mfkiwl/STM32H743_HW/README.md

# IT_Asset_Tracking_Rack_Controller-H743_HW
HW files for the Asset Tracking Rack Controller. It's  based on a STM32H743BIT6 4 layer board which is powered by PoE.
