mfkiwl/STM32H743_HW/Project Outputs for IT_Asset_Tracking_Rack_Controller-H743/Bill of Materials-IT_Asset_Tracking_Rack_Controller-H743.xls

Designator | value | Description | Manufacturer PartNr | Footprint/Package | Replaceable | Quantity
C10, C25, C31, C32, C36 | 4.7uF | 4.7µF ±10% 10V Ceramic Capacitor X5R 0603 (1608 Metric), 4.7µF ±10% 16V Ceramic Capacitor X5R 0603 (1608 Metric), 4.7µF ±10% 35V Ceramic Capacitor X5R 0603 (1608 Metric) | C0603C475K8PACTU | 0603 (1608 metric) | yes | 5
C35 | 4.70uF | 4.7µF Molded Tantalum Capacitors 6.3V 0603 (1608 Metric) 7.5Ohm | TACL475K006XTA | 0603 (1608 Metric) | yes | 1
R2 | 0R | 0 Ohms Jumper 0.1W, 1/10W Chip Resistor 0603 (1608 Metric) Moisture Resistant Thick Film | RC0603JR-070RL | 0603 (1608 metric) | yes | 1
R46, R85, R86 | 0R | 0 Ohms Jumper 0.125W, 1/8W Chip Resistor 0805 (2012 Metric) Automotive AEC-Q200 Thick Film | ERJ-6GEY0R00V | 0805 (2012 metric) | yes | 3
R100, R107 | 0R | 0 Ohms Resistor 0402 | ERJ-2GE0R00X | 0402 (1005 metric) | yes | 2
C1, C2, C3, C4, C5, C6, C7, C8, C12, C14, C15, C16, C17, C18, C19, C20, C22, C23, C40, C46, C49, C50, C51, C52, C54, C78, C83, C103, C104 | 100nF | 0,1µF ±10% 10V Keramikkondensatoren X7R 0402 (1005 metrisch), 0.1µF ±10% 6.3V Ceramic Capacitor X7R 0402 (1005 Metric) | CC0402KRX7R6BB104 | 0402 (1005 metric) | yes | 29
C21, C27, C28, C33, C34, C37, C38, C39, C56, C63, C70, C72, C87, C91, C92, C98, C100, C101, C102 | 0.1uF | 0.1µF ±20% 10V Ceramic Capacitor X5R 0402 (1005 Metric), 0.1µF ±20% 16V Ceramic Capacitor X7R 0402 (1005 Metric), 0.1µF ±10% 16V Ceramic Capacitor X7R 0402 (1005 Metric) | 885012105010 | 0402, 0402 (1005 Metric) | yes | 19
C89 | 0.5pF | 0.5pF ±0.05pF 50V Ceramic Capacitor C0G, NP0 0402 (1005 Metric), Murata | GJM1555C1HR50WB01D | 0402 (1005 metric) | yes | 1
C88 | 0.8pF | 0.8pF ±0.1pF 50V Ceramic Capacitor C0G, NP0 0402 (1005 Metric) | GJM1555C1HR80BB01D | 0402 (1005 metric) | yes | 1
R31 | 1K5 | 1 kOhms ±0.5% 0.063W, 1/16W Chip Resistor 0402 (1005 Metric) Thin Film | CRGCQ0402F1K5 | 0402 (1005 metric) | yes | 1
R87 | 1K | 1 kOhms ±0.5% 0.063W, 1/16W Chip Resistor 0402 (1005 Metric) Thin Film | RR0510P-102-D | 0402 (1005 metric) | yes | 1
R6, R58 | 1M | 1 MOhms ±1% 0.1W, 1/10W Chip Resistor 0402 (1005 Metric) Anti-Sulfur Thin Film | MCS04020C1004FE000 | 0402 (1005 metric) | yes | 2
C24, C26, C81, C82, C99 | 1uF | 1µF ±10% 10V Ceramic Capacitor X7S 0402 (1005 Metric), 1µF ±10% 16V Ceramic Capacitor X5R 0603 (1608 Metric) | GCM155C71A105KE38D | 0402 (1005 metric), 0603 (1608 Metric) | yes | 5
C11, C13, C41 | 1uF | 1µF ±10% 25V Ceramic Capacitor X5R 0603 (1608 Metric) | C0603C105K3PACTU | 0603 (1608 metrisch) | yes | 3
R60, R61, R62 | 1.2K | 1.2 kOhms ±0.5% 0.063W, 1/16W Chip Resistor 0402 (1005 Metric) Thin Film | ERA-2AED122X | 0402 (1005 metric) | yes | 3
P1 | M50-3530242 | 2 Pin, 1 Row, Jumper, 1.27mm | M50-3530242 | 1.27mm | yes | 1
E1 | ANT 2.4GHZ | 2,4GHz Bluetooth, Wi-Fi, Zigbee PCB HF-Antenna,1dBi SMD, Antenova | A5839 | specific see datasheet | no | 1
C42, C43, C47 | 2.2uF | 2.2µF ±20% 25V Ceramic Capacitor X5R 0402 (1005 Metric), Multilayer Ceramic Capacitors MLCC - SMD/SMT 0402 2.2uF 6.3volts *Derate Voltage/Temp | GRM155R61E225ME15D | 0402 (1005metric) | yes | 3
R8 | 3K3 | 3.3 kOhms ±0.1% 0.063W, 1/16W Chip Resistor 0402 (1005 Metric) Automotive AEC-Q200 Thin Film | ERA-2AEB332X | 0402 (1005metric) | yes | 1
L6 | 3.3nH | 3.3nH Unshielded Multilayer Inductor 800mA 170mOhm Max 0402 (1005 Metric) | LQG15HS3N3S02D | 0402 (1005 metric) | no | 1
R18 | 4.7K | 4.7 kOhms ±5% 0.063W, 1/16W Chip Resistor 0402 (1005 Metric) Moisture Resistant Thick Film | RC0402JR-074K7L | 0402 (1005) | yes | 1
C9, C53, C76, C77, C79 | 4.7uF | 4.7µF ±10% 10V Ceramic Capacitor X5R 0402 (1005 Metric), 4.7µF ±10% 6.3V Ceramic Capacitor X7R 0603 (1608 Metric) | CL05A475KP5NRNC | 0402 (1005 metric), 0603 (1608 metric) | yes | 5
C30 | 4.7uF | 4.7µF ±20% 6.3V Ceramic Capacitor X5R 0402 (1005 Metric) | GRM155R60J475ME47D | 0402 (1005 metric) | yes | 1
P5, P8 |  | 6Pin, 2Rows, MICRO LOW-PROFILE TERMINAL STRIPS | FTS-103-02-F-DV | see datasheet |  | 2
R80 | 7K15 | 7.15 kOhms ±0.1% 0.063W, 1/16W Chip Resistor 0402 (1005 Metric) Anti-Sulfur, Automotive AEC-Q200 Thin Film | RQ73C1E7K15BTD | 0402 (1005 metric) | yes | 1
R21 | 8.06K | 8.06 kOhms ±1% 0.063W, 1/16W Chip Resistor 0402 (1005 Metric) Moisture Resistant Thick Film | 311-8.06KLRCT-ND | 0402 (1005) | yes | 1
L4 | 8.2µH | 8.2µH Semi-Shielded Wirewound Inductor 3.7A 45mOhm Max Nonstandard | SRN8040-8R2Y | Specific see datasheet | no | 1
U9 | LAN8742A-CZ-TR | 10/100M RMII Ethernet transceiver 24-SQFN (4x4) | LAN8742A-CZ-TR | 24-VFQFN Exposed Pad | no | 1
C71 | 10uF | 10µF ±20% 10V Ceramic Capacitor X5R 0402 (1005 Metric) | CL05A106MP8NUB8 | 0402 (1005 metric) | yes | 1
C48 | 10uF | 10µF Molded Tantalum Capacitors 10V 1206 (3216 Metric) 3.4Ohm | 293D106X9010A2TE3 | 1206 (3216 metric) | yes | 1
C66, C67 | 10uF | 10µF Molded Tantalum Capacitors 10V 1206 (3216 Metric) 3.4Ohm | 293D106X9010A2TE3 | 1206 (3216 metric) | yes | 2
L1 | 10µH, 200mΩ | 10µH Shielded Wirewound Inductor 1.7A 200mOhm Max Nonstandard | FDSD0420-H-100M=P3 | Specific see datasheet | no | 1
L5 | 10uH | 10µH Unshielded Wirewound Inductor 80mA 360mOhm 0603 (1608 Metric) | LBMF1608T100K | 0603 (1608 metric) | no | 1
C61, C96, C97 | 10pF | 10pF ±1% 50V Ceramic Capacitor C0G, NP0 0402 (1005 Metric) | GJM1555C1H100FB01D | 0402 (1005 metric) | yes | 3
C44, C45 | 11pF | 11pF ±5% 50V Ceramic Capacitor C0G, NP0 0402 (1005 Metric) | GRM1555C1H110JA01D | 0402 (1005 metric) | yes | 2
C74, C75, C84, C85 | 12pF | 12pF ±2% 50V Ceramic Capacitor C0G, NP0 0402 (1005 Metric) | GRM1555C1H120GA01D | 0402 (1005 metric) | yes | 4
R41 | 12K1 | 12.1 kOhms ±1% 0.063W, 1/16W Chip Resistor 0402 (1005 Metric) Moisture Resistant Thick Film | RC0402FR-0712K1L | 0402 (1005 metric) | yes | 1
J3 | 5034801400 | 14 Position FFC, FPC Connector Contacts, Top and Bottom, Pitch 0.020" (0.50mm) Surface Mount, Right Angle | 5034801400 | specific, see datasheet | no | 1
L3 | 15uH | 15nH Unshielded Multilayer Inductor 320mA 460mOhm Max 0402 (1005 Metric), Taiyo Yuden | HK100515NJ-T | 0402 (1005 metric) | no | 1
R12 | 22K | 22 kOhms ±5% 0402 (1005 metrisch) Thick Film | RC0402JR-0722KL | 0402 (1005 metric) | yes | 1
X2 | NX2520SD-24MHZ-EXS00A-CS06352 | 24MHz ±15ppm Crystal 12pF 50 Ohms 4-SMD, No Lead | NX2520SD-24MHZ-EXS00A-CS06352 | 4-SMD, No Lead | no | 1
R76 | 24K9 | 24.9 kOhms ±1% 0.1W, 1/10W Chip Resistor 0402 (1005 Metric) Thick Film | ERJ-2RKF2492X | 0402 (1005 metric) | yes | 1
X4 | ECS-250-10-33B-CKM-TR / 25MHZ 10PF | 25MHz ±10ppm Crystal 10pF 40 Ohms 4-SMD, No Lead | ECS-250-10-33B-CKM-TR | 4-SMD, No Lead | no | 1
R82 | 31.6K | 31.6 kOhms ±0.1% 0.063W, 1/16W Chip Resistor 0402 (1005 Metric) Automotive AEC-Q200 Thin Film | ERA-2AEB3162X | 0402 (1005 metric) | yes | 1
X1, X5 | NX3215SA-32.768K-STD-MUA-9 | 32.768kHz ±20ppm Crystal 9pF 70 kOhms 2-SMD, No Lead | NX3215SA-32.768K-STD-MUA-9 | 2-SMD, specific see datasheet | no | 2
R13, R32, R33, R34 | 33R | 33 Ohms ±0.1% 0.063W, 1/16W Chip Resistor 0402 (1005 Metric) Thin Film | CPF0402B33RE1 | 0402 (1005metric) | yes | 4
R83 | 33.2K | 33.2 kOhms ±0.1% 0.063W, 1/16W Chip Resistor 0402 (1005 Metric) Thin Film | CPF0402B33K2E1 | 0402 (1005metric) | yes | 1
R11, R22, R23, R24, R25, R26 | 47K | 47 kOhms ±5% 0.063W, 1/16W Chip Resistor 0402 (1005 Metric) Automotive AEC-Q200, Moisture Resistant Thick Film | CRGCQ0402J47K | 0402 (1005 metric) | yes | 6
R37, R38, R39, R40 | 49R9 | 49.9 Ohms ±0.1% 0.063W, 1/16W Chip Resistor 0402 (1005 Metric) Automotive AEC-Q200 Thin Film | ERA-2AEB49R9X | 0402 (1005 metric) | yes | 4
R17, R35, R47 | 51R | 51 Ohms ±5% 0.063W, 1/16W Chip Resistor 0402 (1005 Metric) , Thick Film, 51 Ohms ±0.5% 0.063W, 1/16W Chip Resistor 0402 (1005 Metric) Thin Film | RC0402JR-0751RL | 0402 (1005 metric) | yes | 3
R7 | 71K5 | 71.5 kOhms ±1% 0.1W, 1/10W Chip Resistor 0402 (1005 Metric) Automotive AEC-Q200, Moisture Resistant Thick Film | RK73H1ETTP7152F | 0402 (1005 metric) | yes | 1
D10 | SZ1SMA58AT3G | 93.6V Clamp 4.3A Ipp Tvs Diode Surface Mount SMA | SZ1SMA58AT3G | DO-214AC, SMA | no | 1
R74 | 95K3 | 95.3 kOhms ±0.1% 0.063W, 1/16W Chip Resistor 0402 (1005 Metric) Automotive AEC-Q200 Thin Film | ERA-2AEB9532X | 0402 (1005 metric) | no | 1
R15, R19, R59 | 100K | 100 kOhms ±0,1% 0,063W, 1/16W Chip-Widerstand 0402 (1005 metrisch) Dünnschicht | RT0402BRD07100KL | 0402 (1005 metrisch) | yes | 3
R99 | 100K | 100 kOhms ±0.1% 0.125W, 1/8W Chip Resistor 0805 (2012 Metric) Automotive AEC-Q200 Thin Film | ERA-6AEB104V | 0805 (2012 metric) | yes | 1
R48 | 0R1 | 100 mOhms ±1% 5W Chip Resistor 4527 J-Lead Anti-Sulfur, Automotive AEC-Q200, Current Sense, Moisture Resistant | WSR5R1000FEA | 4527 (11570 metric) | no | 1
C29 | 100uF | 100µF ±20% 6.3V Ceramic Capacitor X5R 1206 (3216 Metric) | GRM31CR60J107ME39L | 1210 (3225 metric) | yes | 1
C62 | 100uF | 100µF ±20% 10V Ceramic Capacitor X5R 1210 (3225 Metric) | GRM32ER61A107ME20L | 1210 (3225 metric) | yes | 1
C86 | 100pF | 100pF ±5% 10V Keramikkondensatoren C0G, NP0 0402 (1005 metrisch) | 885012005013 | 0402 (1005 metric) | yes | 1
R78 | 105K | 105 kOhms ±1% 0.1W, 1/10W Chip Resistor 0402 (1005 Metric) Automotive AEC-Q200 Thick Film | ERJ-2RKF1053X | 0402 (1005 metric) | yes | 1
L7, L8, L9 | 120R(Z) | 120 Ohms @ 100MHz 1 Power Line Ferrite Bead 0603 (1608 Metric) 2A 50mOhm | BLM18PG121SN1D | 0603 (1608 metric) | yes | 3
C58, C73 | 130pF | 130pF ±5% 50V Ceramic Capacitor C0G, NP0 0805 (2012 Metric) | C0805C131J5GAC7800 | 0805 (2012 metric) | yes | 2
R81 | 249K | 249 kOhms ±1% 0.063W, 1/16W Chip Resistor 0402 (1005 Metric) Automotive AEC-Q200 Thick Film | CRCW0402249KFKED | 0402 /1005 Metric) | yes | 1
R10, R44, R45 | 330R | 330 Ohms ±0.1% 0.063W, 1/16W Chip Resistor 0402 (1005 Metric) Automotive AEC-Q200 Thin Film | ERA-2AEB331X | 0402 (1005metric) | yes | 3
R75 | 357R | 357 Ohms ±1% 0.063W, 1/16W Chip Resistor 0402 (1005 Metric) Thick Film | CR0402-FX-3570GLF | 0402 (1005 metric) | yes | 1
F1 | 375mA/125VAC | 375mA, 125V AC 125V DC Fuse with surfacemount holder, 2-SMD | 0154.375DR | 2-SMD see datasheet | no | 1
C68 | 470pF | 470pF ±10% 16V Ceramic Capacitor X7R 0402 (1005 Metric) | 0402YC471KAT2A | 0402 (1005 metric) | yes | 1
R9 | 620R | 620Ohm, SMD 0402, 1/16W 0.5% | RR0510P-621-D | 0402 (1005 metric) | yes | 1
R14 | 820R | 820 Ohms ±1% 0.1W, 1/10W 0402 Thick Film | ERJ-2RKF8200X | 0402 (1005 metric) | yes | 1
C93 | 820pF | 820pF ±5% 50V Ceramic Capacitor C0G, NP0 0402 (1005 Metric) | GRM1555C1H821JA01J | 0402 (1005 metric) | no | 1
C64, C65 | 1nF/2KV | 1000pF ±10% 2000V (2kV) Ceramic Capacitor X7R 1206 (3216 Metric) | 1206GC102KAZ1A | 1206 (3216 Metric) | yes | 2
C60 | 3nF | 3000pF, 3nF, ±5% 10V Ceramic Capacitor U2J 0402 (1005 Metric) | GRM1557U1A302JA01D | 0402 (1005 Metric) | yes | 1
C59 | 6.8nF | 6800pF ±10% 50V Ceramic Capacitor X7R 0402 (1005 Metric) | C0402C682K5RACTU | 0402 (1005 metric) | yes | 1
U1 | STM32H743BIT6 | ARM Cortex-M7 STM32H7 Mikrocontroller IC 32-Bit 480MHz 2MB (2M x 8) FLASH 208-LQFP (28x28) | STM32H743BIT6 | 208-LQFP (28x28) | no | 1
T1 | DSC2501R0L | Bipolar (BJT) Transistor NPN 20V 500mA 150MHz 200mW Surface Mount Mini3-G3-B-B | DSC2501R0L | TO-236-3, SC-59, SOT-23-3 | no | 1
U4 | TLV61046ADBVT | Boost Switching Regulator IC Positive Adjustable 3.3V 1 Output SOT-23-6 | TLV61046ADBVT | SOT-23-6 | no | 1
U5 | TPS81256SIPR | Boost Switching Regulator IC Positive Fixed 5V 1 Output, Inputrange 2.5 to 5.5V, 9-SMD BGA Module, Texas Instruments | TPS81256SIPR | 9-SMD Module, see datasheet | no | 1
U15 | 74AHC1G125SE-7 | Buffer, Non-Inverting 1 Element 1 Bit per Element 3-State Output SOT-353 | 74AHC1G125SE-7 | SOT353 | no | 1
D1 | ESDA5V3L | Clamp Ipp Tvs Diode Surface Mount SOT-23-6 SMD, used e.g in ESD protection for USB | ESDA6V1BC6 | SOT-23-6 | no | 1
P4, P7 | 3220-20-0300-00-TR | Connector Header Surface Mount 20 position 0.050" (1.27mm) | 3220-20-0300-00-TR | 2x10 Pads, see datasheet | no | 2
X6 | ABM3-32.000MHZ-D2Y-T | Crystal 32MHz ±20ppm Crystal 18pF 25 Ohms 2-SMD, No Lead | ABM3-32.000MHZ-D2Y-T | 2-SMD, specific see datasheet | no | 1
D9 | B360B-13-F | Diode Schottky 60V 3A Surface Mount SMB | B360B-13-F | DO-214AA, SMB | no | 1
C55, C57, C80 | DNP, 1uF | Do not place 0402 (1005 metric) - placeholder, 1µF ±10% 10V Ceramic Capacitor X7S 0402 (1005 Metric) | N/A, GCM155C71A105KE38D | 0402 (1005 metric) | yes | 3
C90, C94, C95 | DNP | Do not place 0805 (2012 metric) - placeholder | N/A | 0805 (2012 metric) | no | 3
L2 | 600R(Z) | Ferritperlen MULTILYR CHP BD 0603 600OHMS 25% | BK1608HS601-T | 0603 | yes | 1
D7 | MBRD5H100T4G | Gleichrichter Diode Schottky 100V 5A Oberflächenmontage DPAK | MBRD5H100T4G | DPAK | no | 1
LD2, LD9, LD10, LD11 | green | Green 570nm LED Indication - Discrete 2.1V 0402 (1005 Metric) | APHHS1005CGCK | 0420 (1005 metric) | yes | 4
J2 |  | Headers & Wire Housings 6P 1.27MM SNGL ROW R/A MALE BLK | 214013 | 1.27mm | no | 1
U3 | TPS7A0522PDBVT | Linear Voltage Regulator IC 1 Output 200mA fixed output at 2.2V, SOT-23-5 | TPS7A0522PDBVT | SOT-23-5 | no | 1
U7 | LD1117S18TR | Linear Voltage Regulator IC 1 Output 800mA fixed output at 1.8V,SOT-223 | LD1117S18TR | SOT-223 | no | 1
T3 | POE_7499211121A | Magjack Connector WE-RJ45 (PoE) with LAN Transformer, 10/100 Base-T1 Port RJ45, 10/100 Base-T, AutoMDIX, two LEDs | 7499211121A | See datasheet | no | 1
SD1 | 1051620001 | Memory Card Connectors 1.45H MICRO SD HEADER WITH D/C PIN, Molex | 1051620001 | See datasheet | no | 1
U16 | NRF52840-QIAA-R | Multi-protocol Bluetooth Low Energy, IEEE 802.15.4, ANT and 2.4GHz proprietary system-on-chip | NRF52840-QIAA-R | 73-AQFN (7x7mm) | no | 1
Q3 | 2N7002WT1G | N-Channel 60V 310mA (Ta) 280mW (Tj) Surface Mount SC-70-3 (SOT323) | 2N7002WT1G | SC-70, SOT-323 | no | 1
R98 | 1M | PANASONIC ELECTRONIC COMPONENTS ERA6AEB105V Surface Mount Chip Resistor, Thin Film, AEC-Q200 ERA Series, 1 Mohm, 125 mW, 0.1%, 100 V | ERA-6AEB105V | 0805 (2012 metric) | yes | 1
Q1 | NTR0202PLT1G | P-Channel 20V 400mA (Ta) 225mW (Ta) Surface Mount SOT-23-3 (TO-236) | NTR0202PLT1G | SOT-23-3 (TO-236) | no | 1
Q2 | FQD17P06TM | P-Channel 60V 12A (Tc) 2.5W (Ta), 44W (Tc) Surface Mount D-Pak | FQD17P06TM | TO-252-3, DPak | no | 1
J1 | Power Jack | PJ-102 Series 2 x 6.5 mm 24 V Horizontal Power Jack w/ Tapered PC Pins,Through Hole, Right Angle | PJ-102AH | THD | no | 1
IC1 | NCP1092DG | Power Over Ethernet Controller 1 Channel 802.3af (PoE) 8-SOIC | NCP1092DG | SOIC | no | 1
U2 | STMPS2151STR | Power Switch/Driver 1:1 N-Kanal 500mA SOT-23-5, STMicroelectronics | STMPS2151STR | SC-74A, SOT-753 | no | 1
LD1 | red | Red 630nm LED Indication - Discrete 1.95V 0402 (1005 Metric) | APHHS1005SURCK | 0420 (1005 metric) | yes | 1
SYMBOL_But, SYMBOL_Top | Overlay | Reichle & De-Massari Logo | Logo on Top Overlay | 2.54mm | no | 2
R1, R5 | DNP | Resistor: do not populate | do not populate | 0603 | no | 2
R49, R50, R51, R52, R53, R54, R55, R56, R57, R150 | DNP | Resistor: do not populate | do not populate | 0805 | no | 10
U8 | EMI-Filter | RLC EMI Filter 3rd Order Low Pass 6 Channel L = 1nH, C = 2.5pF 17-WFBGA, FCBGA | EMIF06-HSD03F3 | 17-WFBGA | no | 1
U14 | RS-485 Interface | RS-485 Interface IC 3.3V Differential Transceivers | SN65HVD11DR | SOIC-8 | no | 1
P3, P6 | Pads | Segger, J-Link 10-pin Needle Adapter | Pads | Pads | no | 2
R95, R97 | 10R | SMD 1/4watt 10ohms 1% | CRCW060310R0FKEAHP | 0603 (1608 metric) | yes | 2
R3, R4, R16, R20, R27, R28, R29, R30, R36, R42, R43, R84, R101, R102, R103, R104, R105, R106 | 10K | SMD 10K ohm 1% 50V General Purpose | RC0402FR-1010KL | 0402 | yes | 18
U13 | TPS54260DGQR | Switching Voltage Regulators 3.5-60V 2.5A 2.5MHz Step Down Converter | TPS54260DGQR | S-PDSO-G10 | no | 1
TVS1 | TBU-PL060-200-WH | TBU-PL Series dual 50 ohm Surge Suppressors, bi-directional | TBU-PL060-200-WH | DFN | no | 1
D11, D12 | Surge Protection | Thyristor Surge Protection Devices (TSPD) PxxxxS4xLRP Series SIDACtor Protection Thyristor 100A 25V Bi SOD | P0080S4BLRP | SOD-123FL | no | 2
D13 | CDSOT23-SM712 | TVSDiode, 26V, 14V Clamp 17A (8/20µs) Ipp, Surface Mount SOT-23-3, Applications RS-485 | CDSOT23-SM712 | DO-214AC-2 (SMA) | no | 1
U6 | USB3320C-EZK-TR | USB3320C, Hi-Speed USB Host, Device or OTG PHY with ULPI Low Pin Interface, 32-QFN (5x5) | USB3320C-EZK-TR | QFN32 | no | 1
P2 | 87583-3010RPLF | USB - A USB 2.0 Receptacle Connector 4 Position Surface Mount, Right Angle | 87583-3010RPLF | SMD, see datasheet | no | 1
D2, D8 | SZBZX84C10LT1G | Zener Diode 10V 225mW ±6% Oberflächenmontage SOT-23-3 (TO-236) | SZBZX84C10LT1G | SOT-23-3 (TO-236) | no | 2
