mfkiwl/STM32H743_HW/Project Outputs for IT_Asset_Tracking_Rack_Controller-H743/IT_Asset_Tracking_Rack_Controller_Schematics.PDF

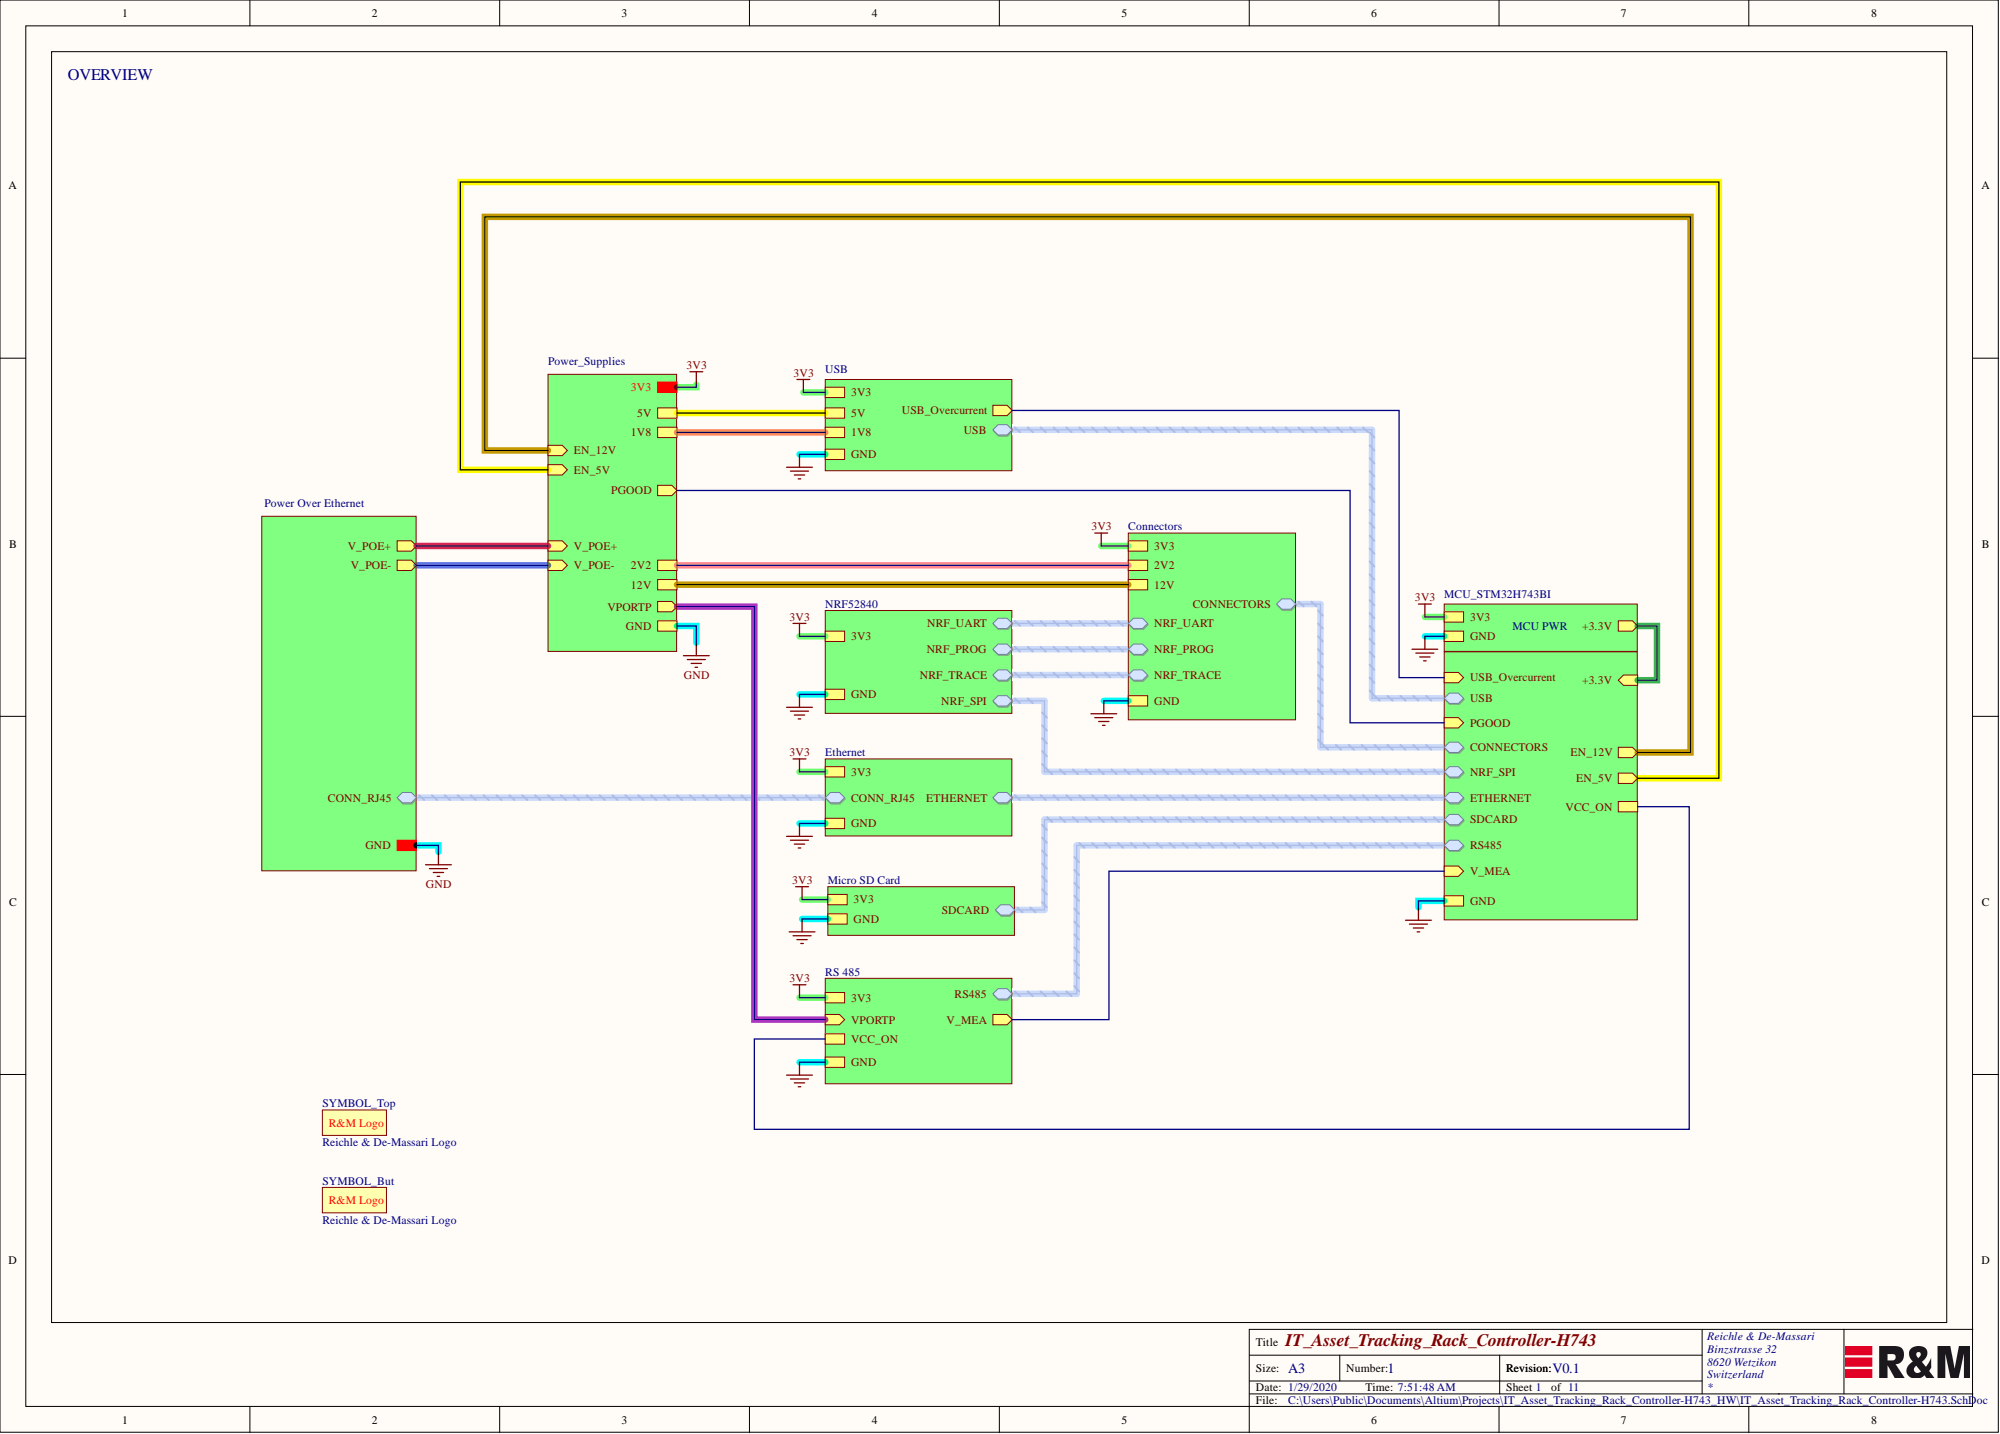
[picture p1: page 1]

IT_Asset_Tracking_Rack_Controller-H743 Title | Reichle & De-Massari Binzstrasse 32 8620 Wetzikon Switzerland

Size: A3 | Number: 1 | Revision: Revision: V0.1
Date: 1/29/2020 Time: 7:51:48 AM | | Sheet of

C:\Users\Public\Documents\Altium\Projects\IT_Asset_Tracking_Rack_Controller-H743_HW\IT_Asset_Tracking_Rack_Controller-H743.SchDoc

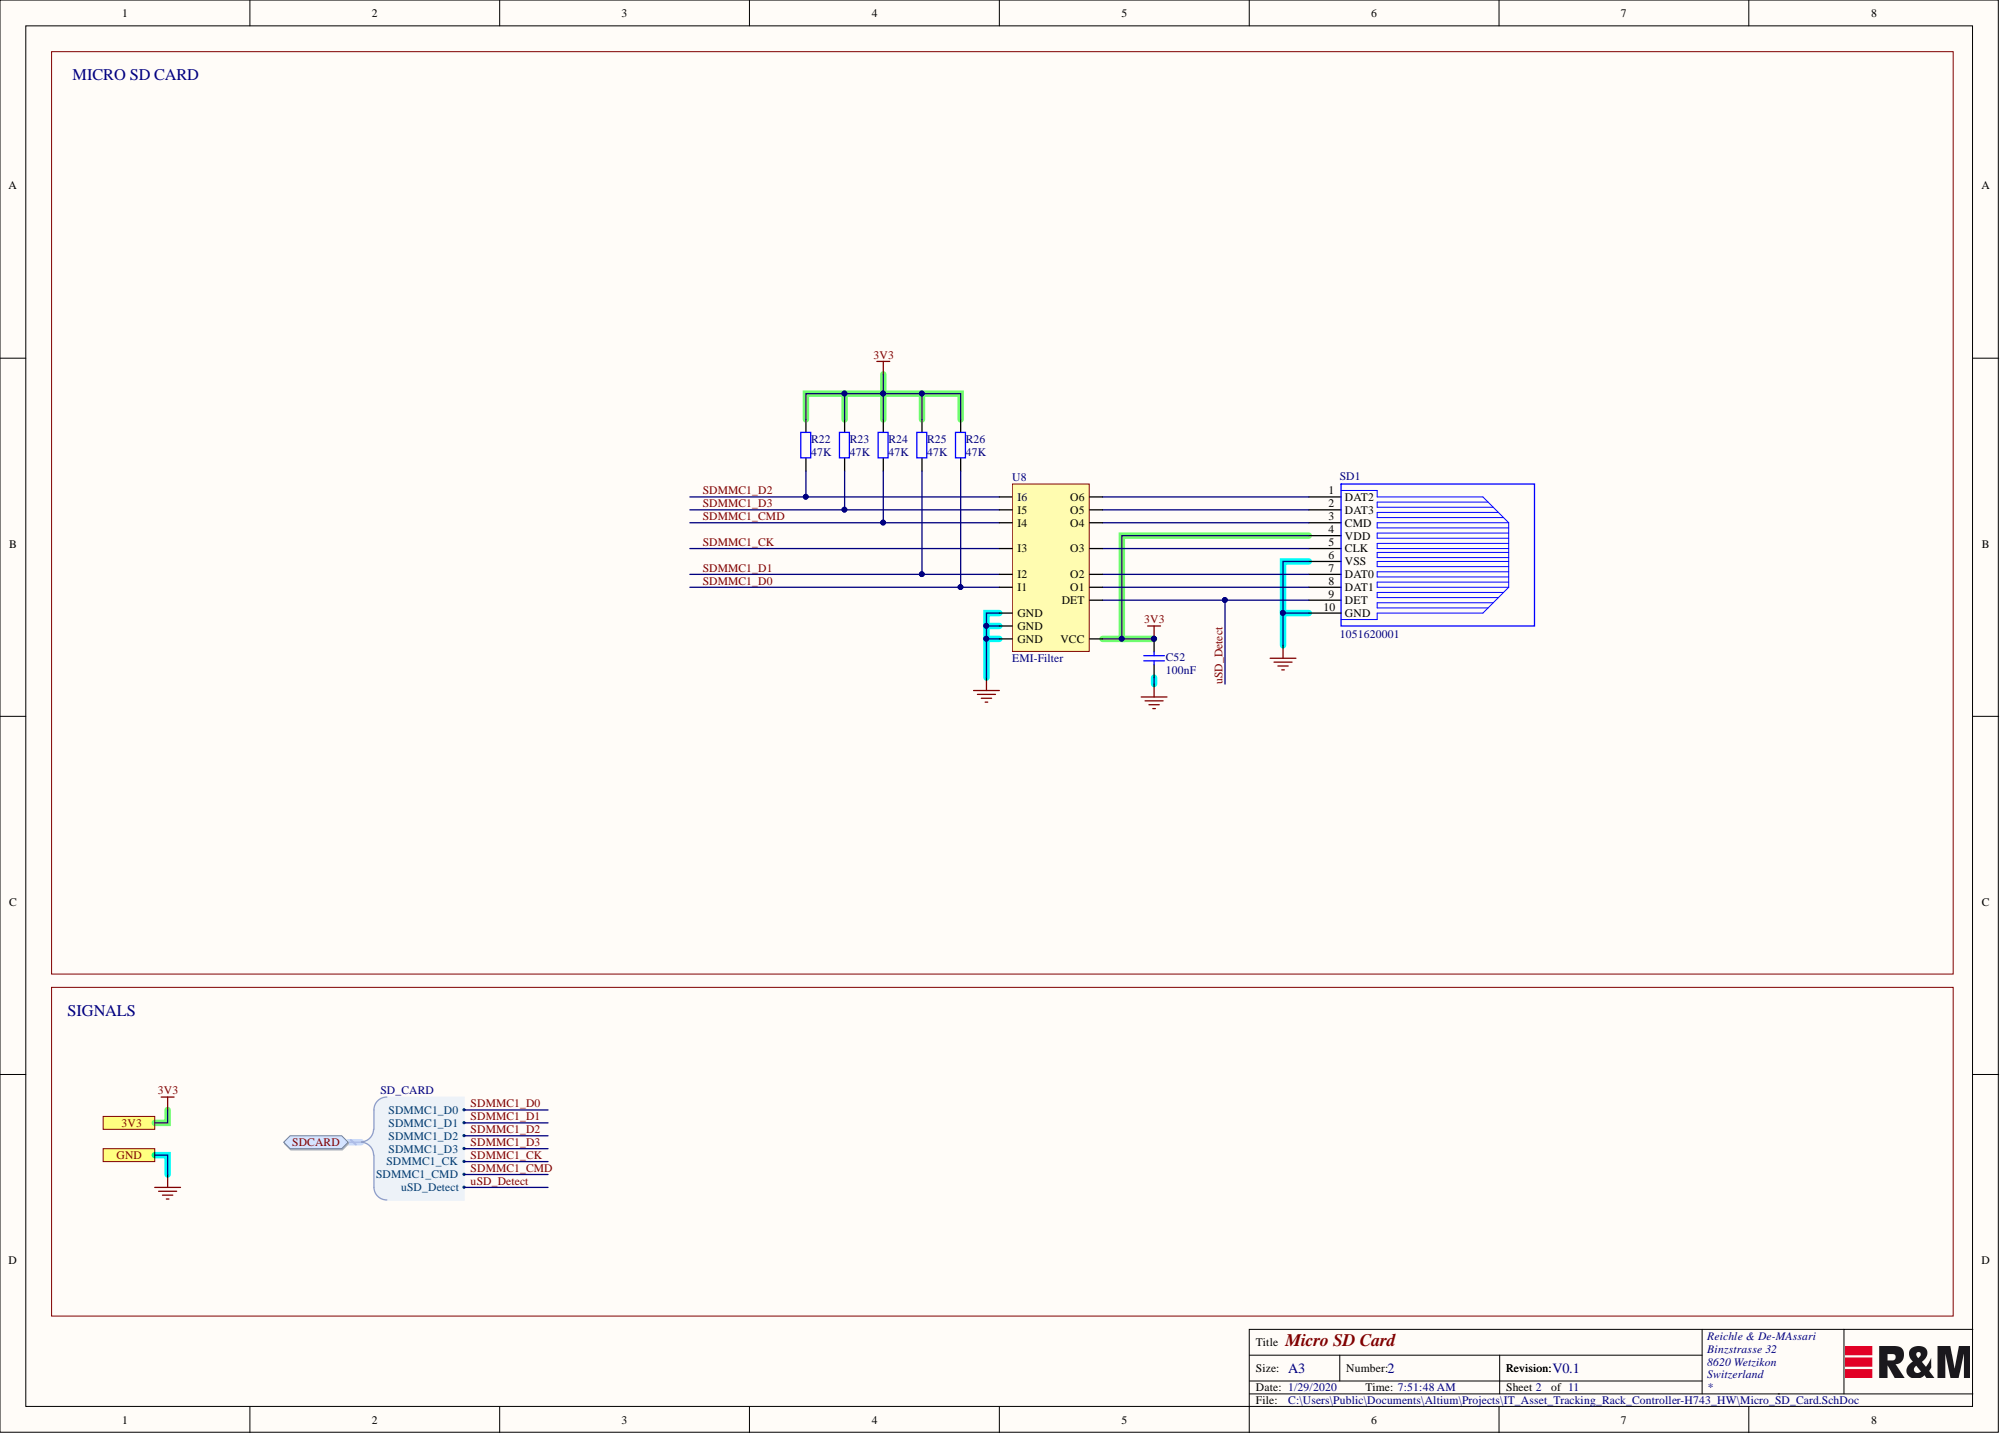
[picture p2: page 2]

VDD 4
CLK 5
VSS 6
DAT0 7
DAT1 8
DET 9

3V3 | | | GND 10

C:\Users\Public\Documents\Altium\Projects\IT_Asset_Tracking_Rack_Controller-H743_HW\Micro_SD_Card.SchDoc

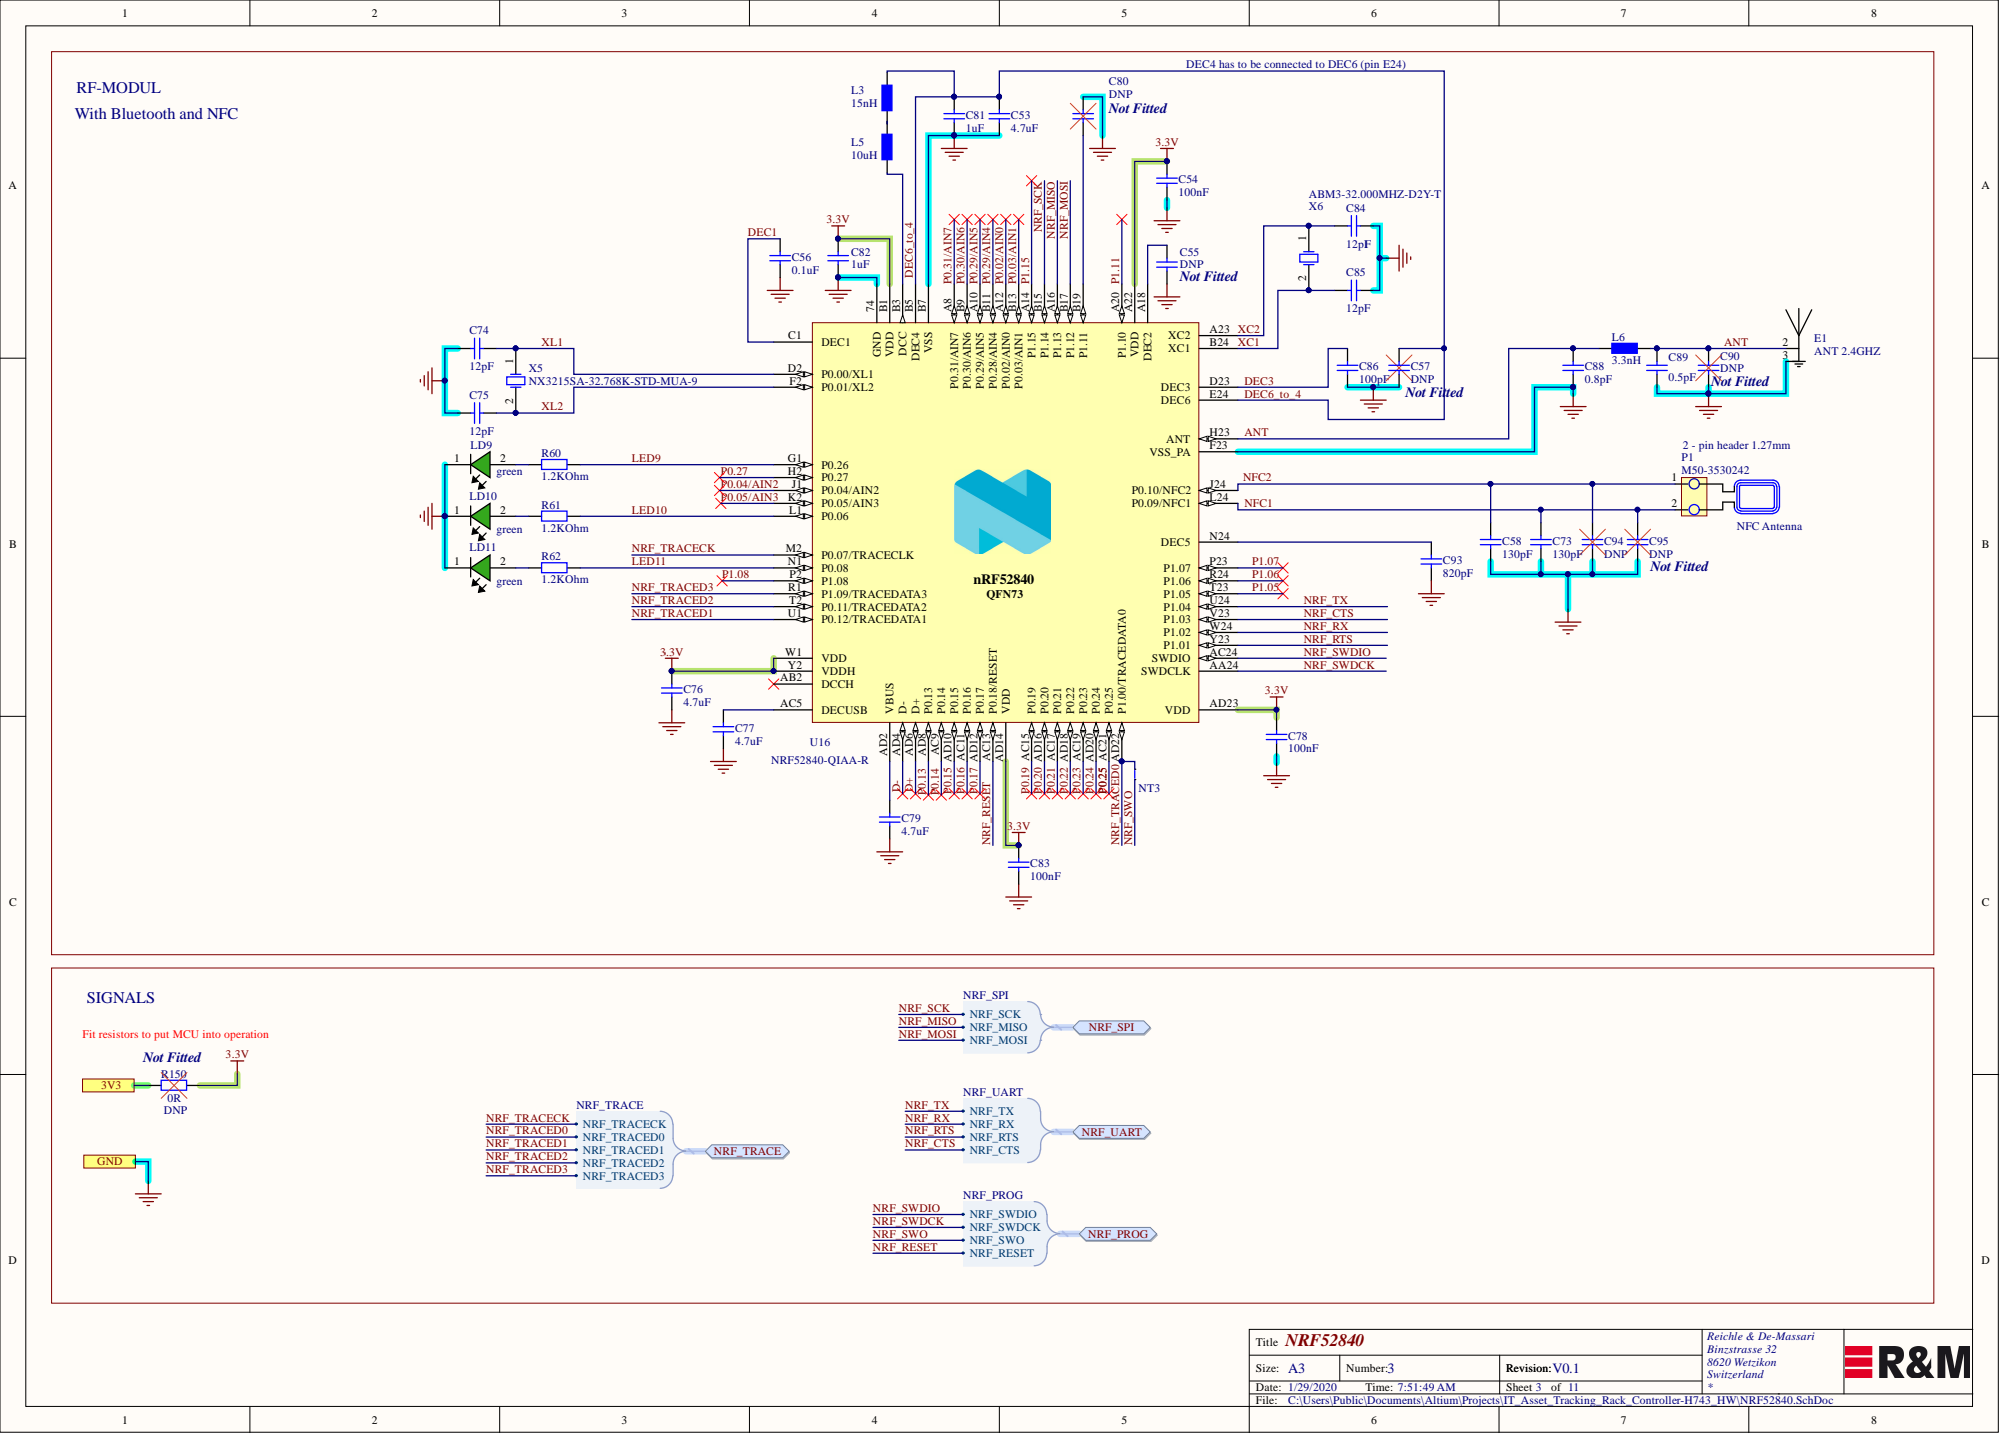
[picture p3: page 3]

DEC4 has to be connected to DEC6 (pin E24)

RF-MODUL
With Bluetooth and NFC

NX3215SA-32.768K-STD-MUA-9
XL2 | P0.26 G1 | DEC6_to_4

Fit resistors to put MCU into operation

C:\Users\Public\Documents\Altium\Projects\IT_Asset_Tracking_Rack_Controller-H743_HW\NRF52840.SchDoc

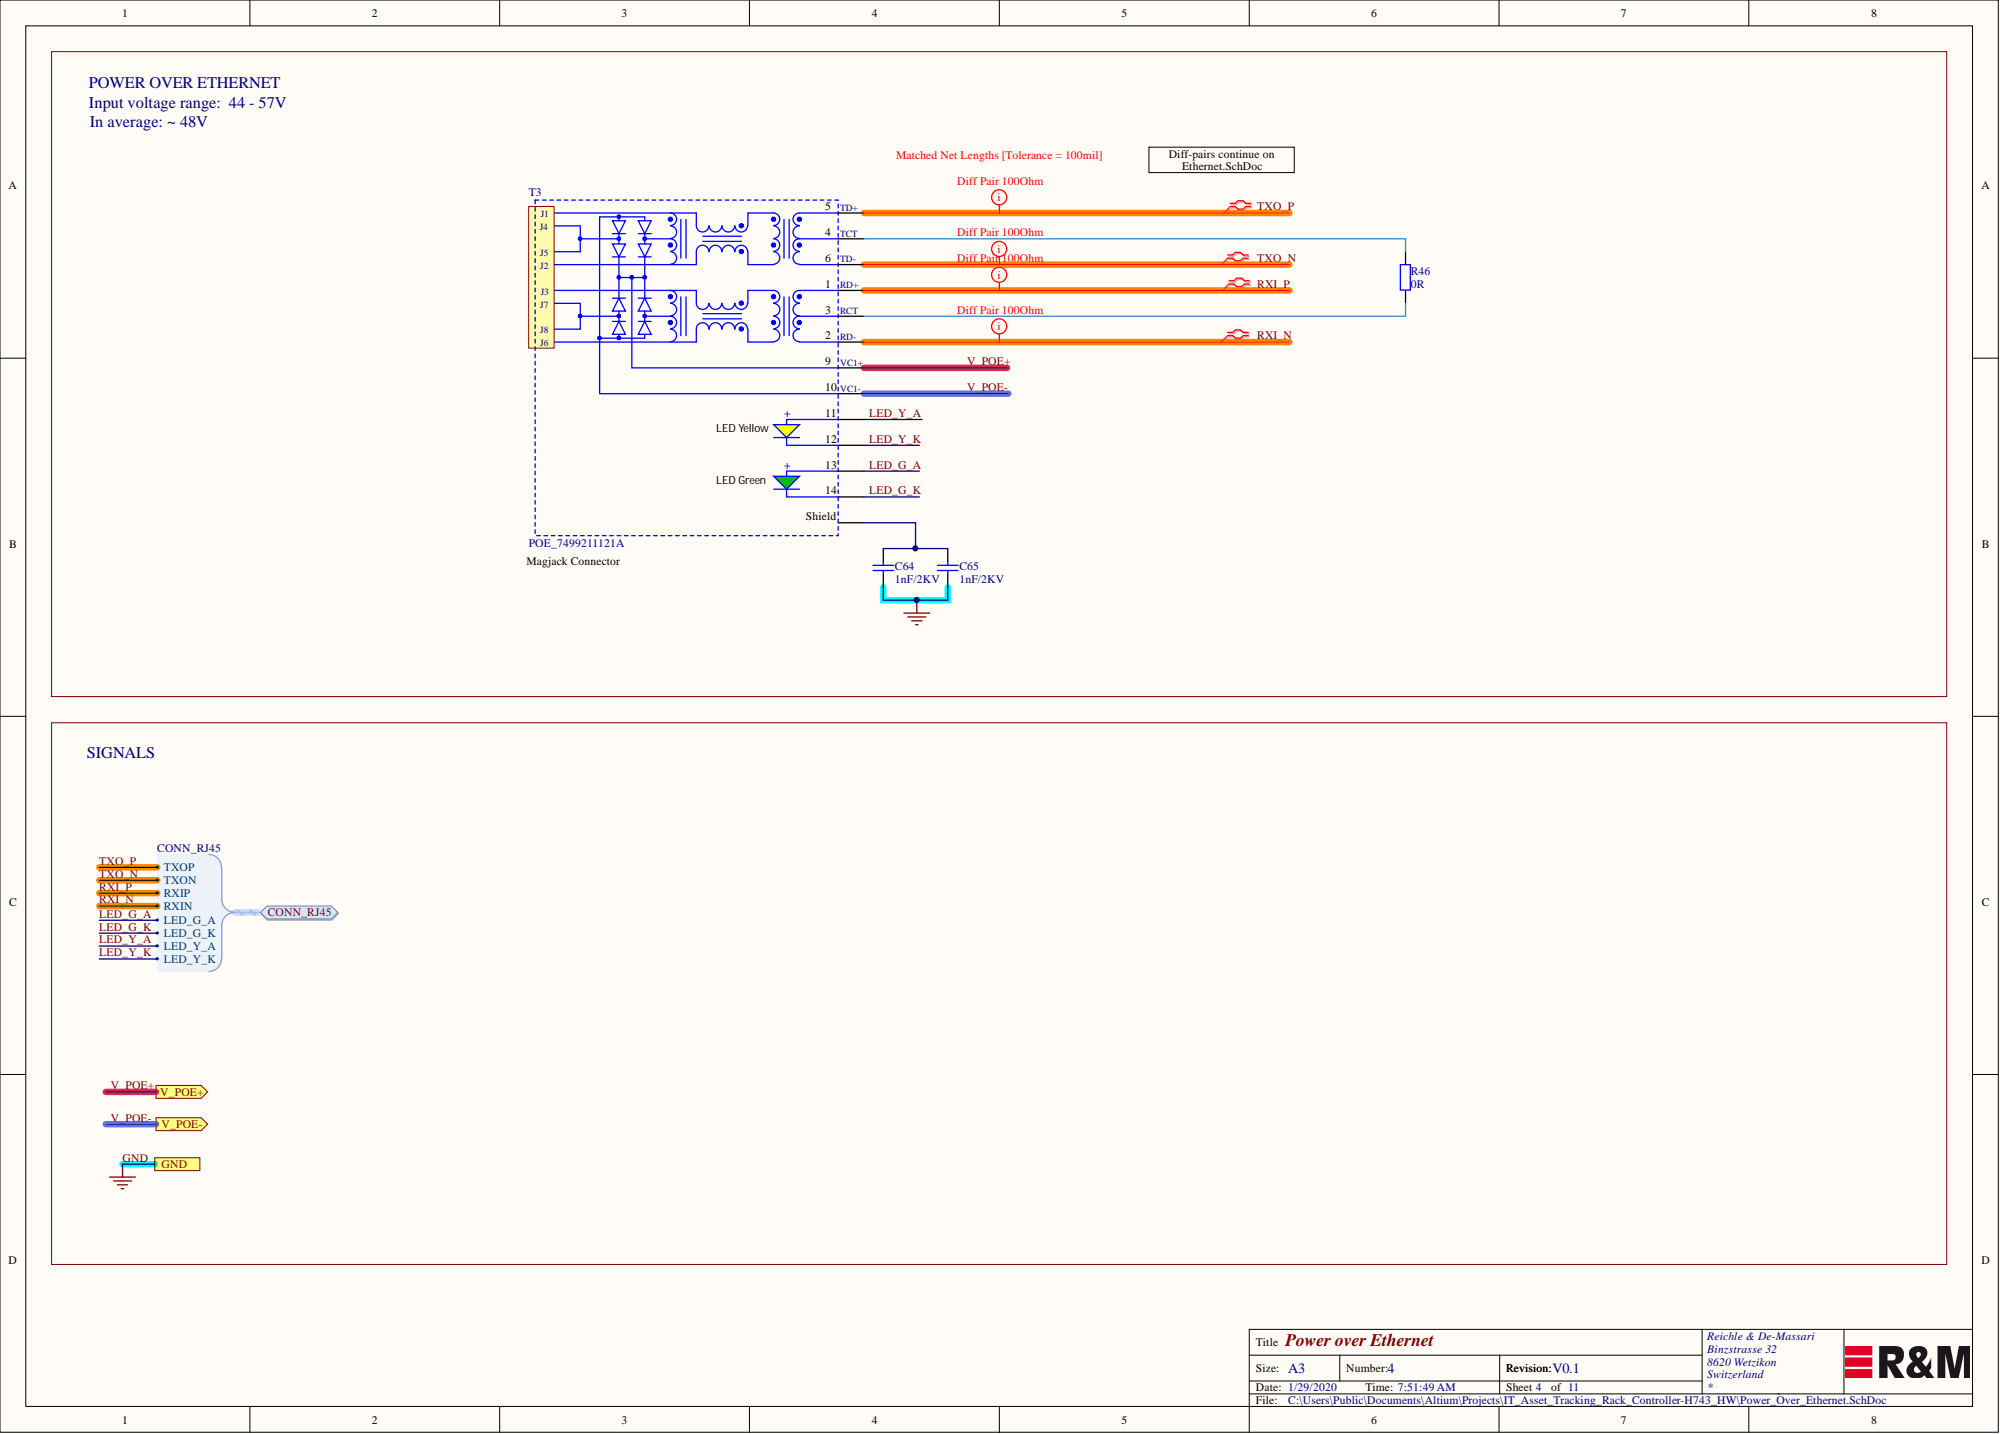
[picture p4: page 4]

Matched Net Lengths [Tolerance = 100mil]

Diff-pairs continue on
Ethernet.SchDoc

C:\Users\Public\Documents\Altium\Projects\IT_Asset_Tracking_Rack_Controller-H743_HW\Power_Over_Ethernet.SchDoc

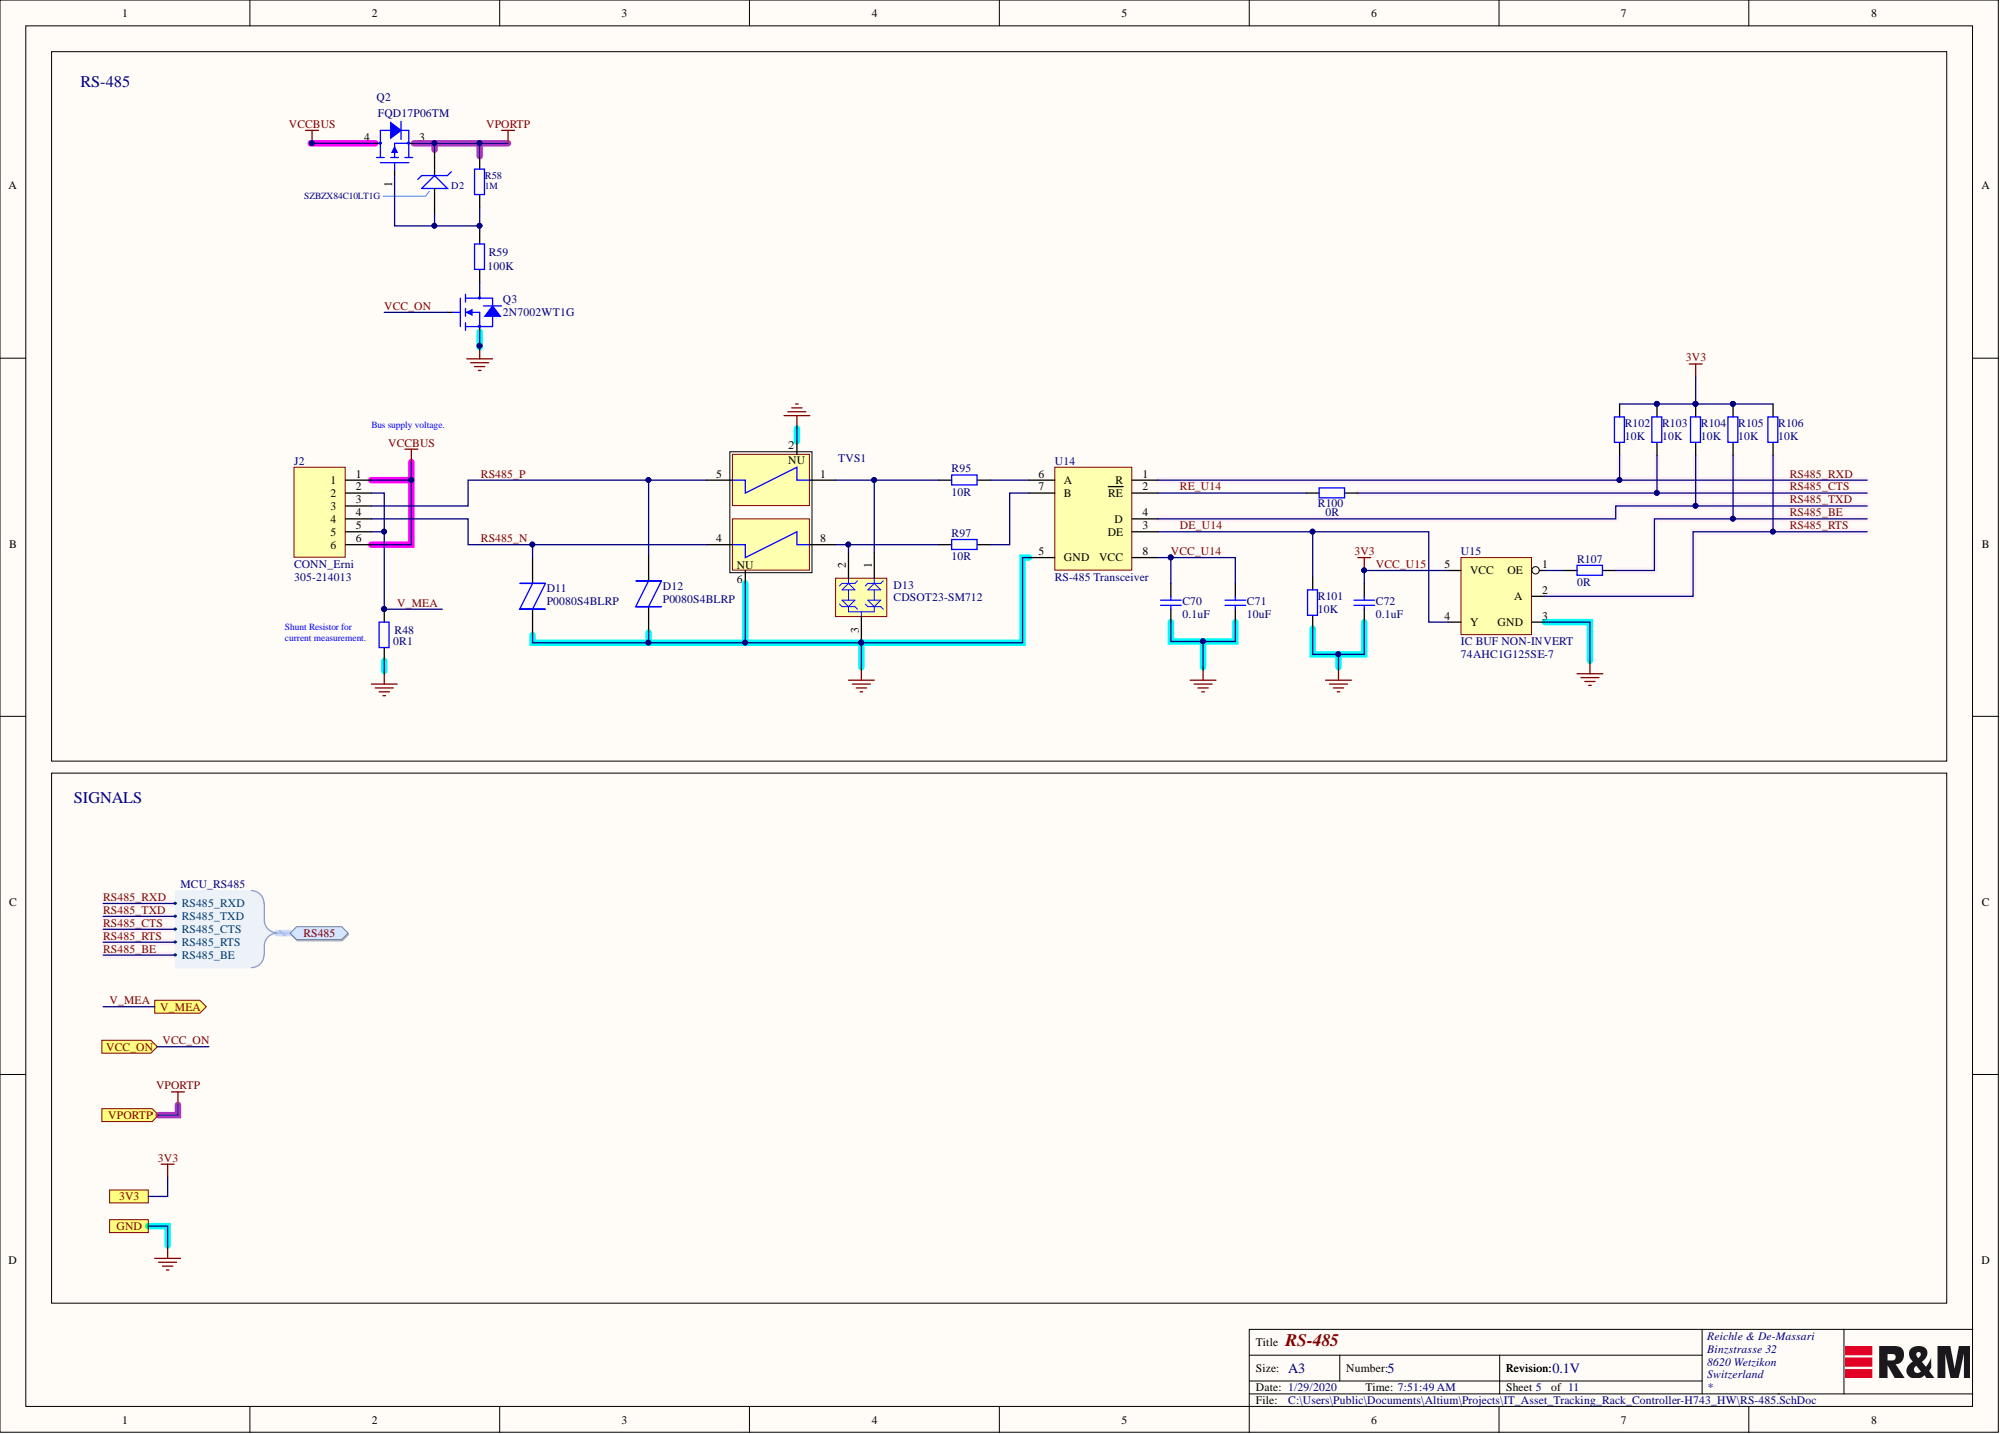
[picture p5: page 5]

IC BUF NON-INVERT
74AHC1G125SE-7

C:\Users\Public\Documents\Altium\Projects\IT_Asset_Tracking_Rack_Controller-H743_HW\RS-485.SchDoc

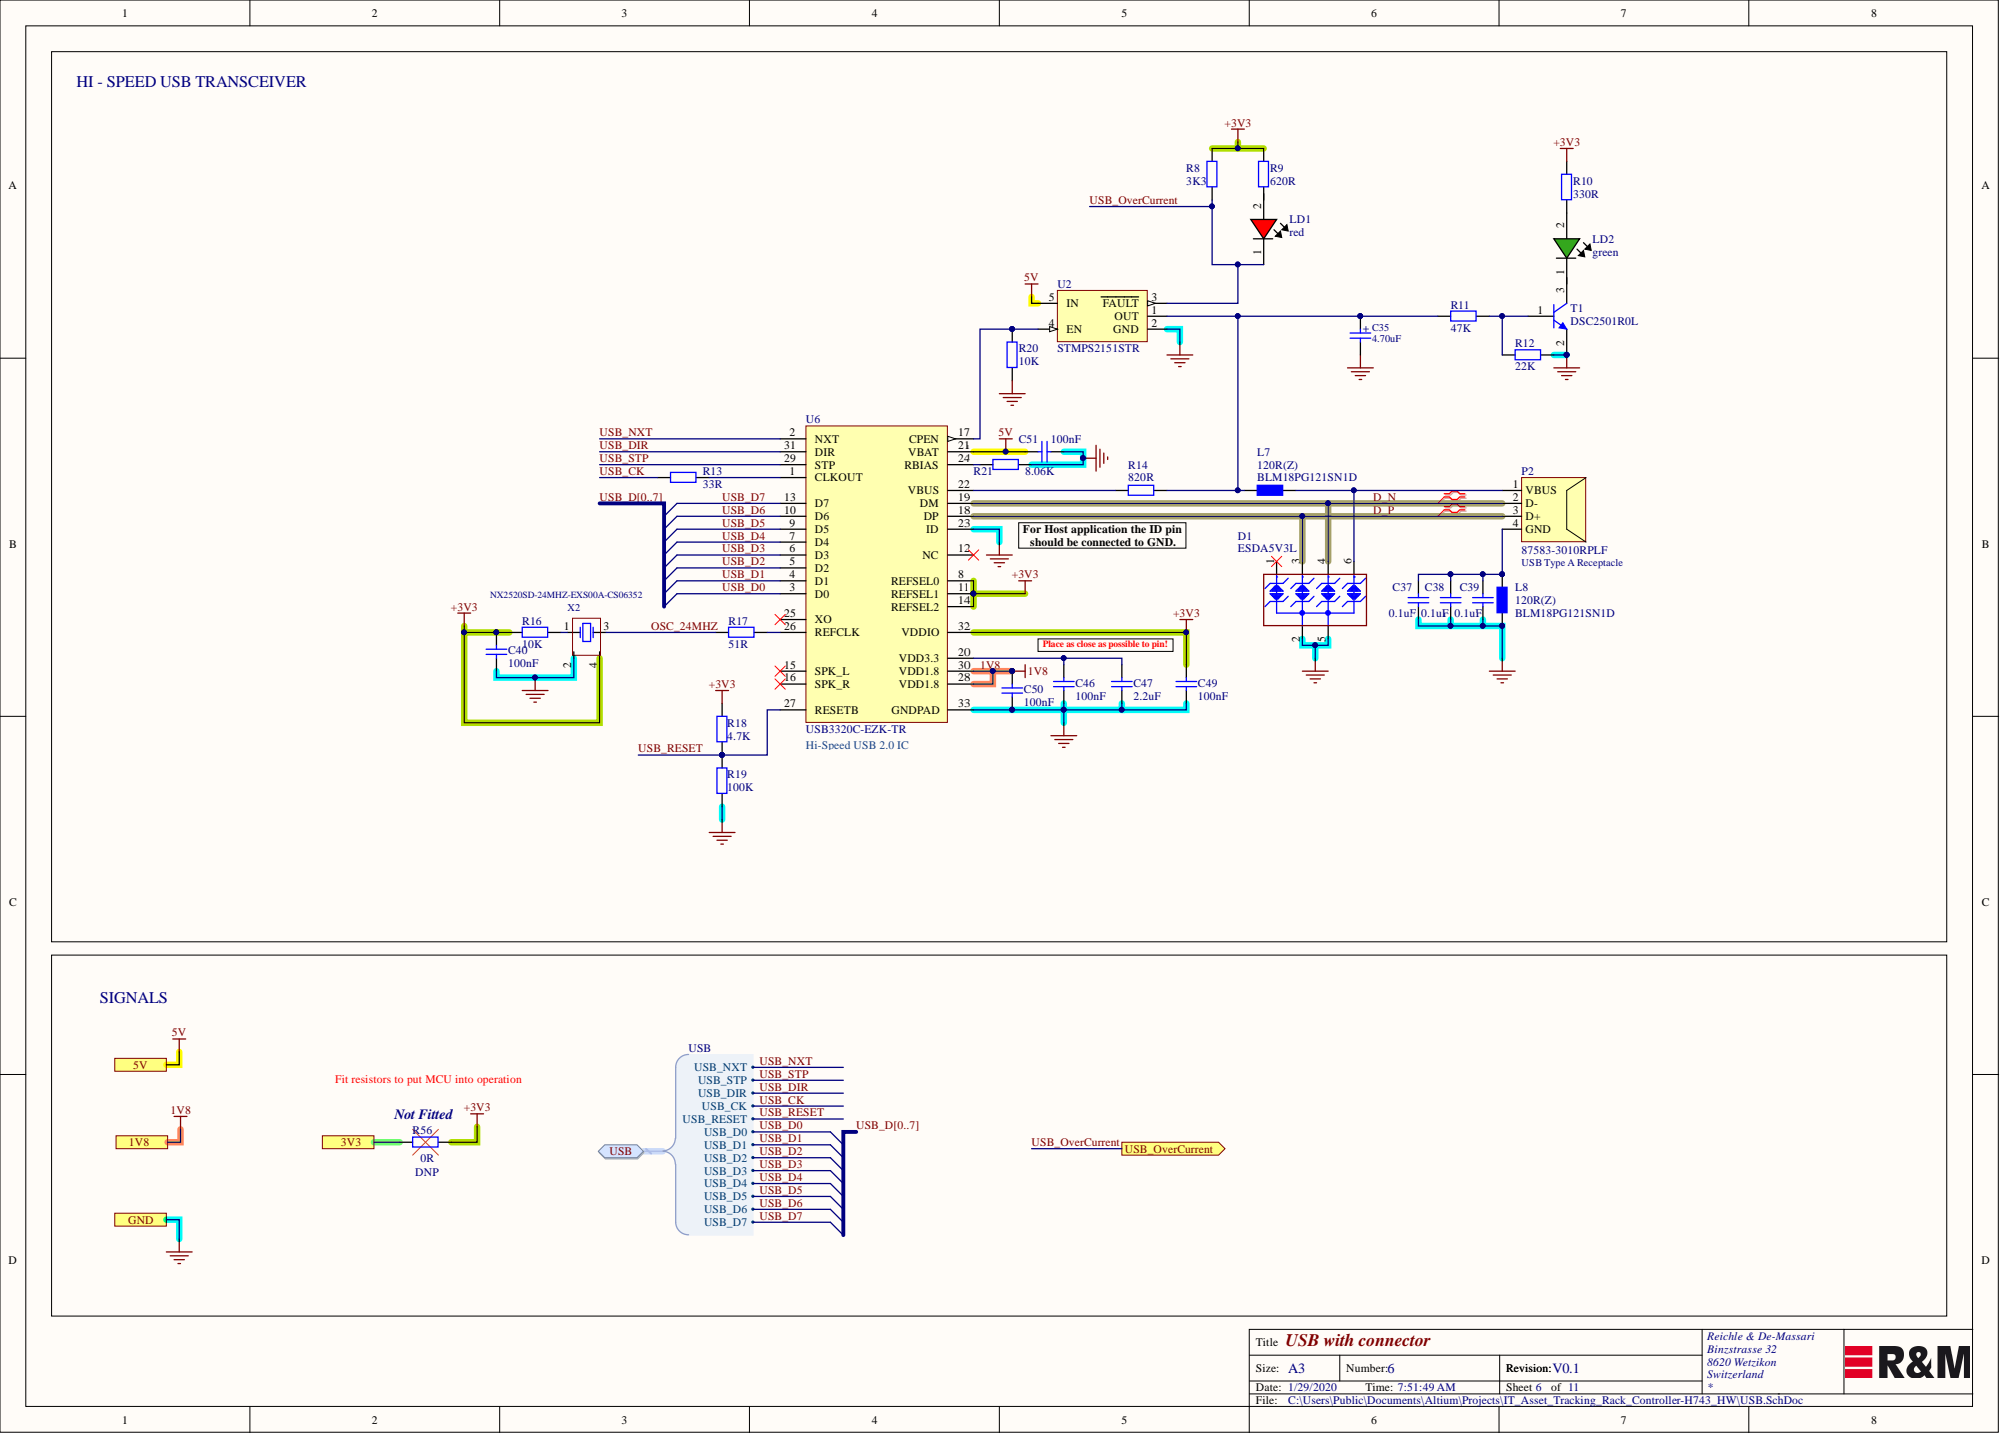
[picture p6: page 6]

HI - SPEED USB TRANSCEIVER

For Host application the ID pin
should be connected to GND.

Place as close as possible to pin!

USB3320C-EZK-TR
Hi-Speed USB 2.0 IC

Fit resistors to put MCU into operation

C:\Users\Public\Documents\Altium\Projects\IT_Asset_Tracking_Rack_Controller-H743_HW\USB.SchDoc

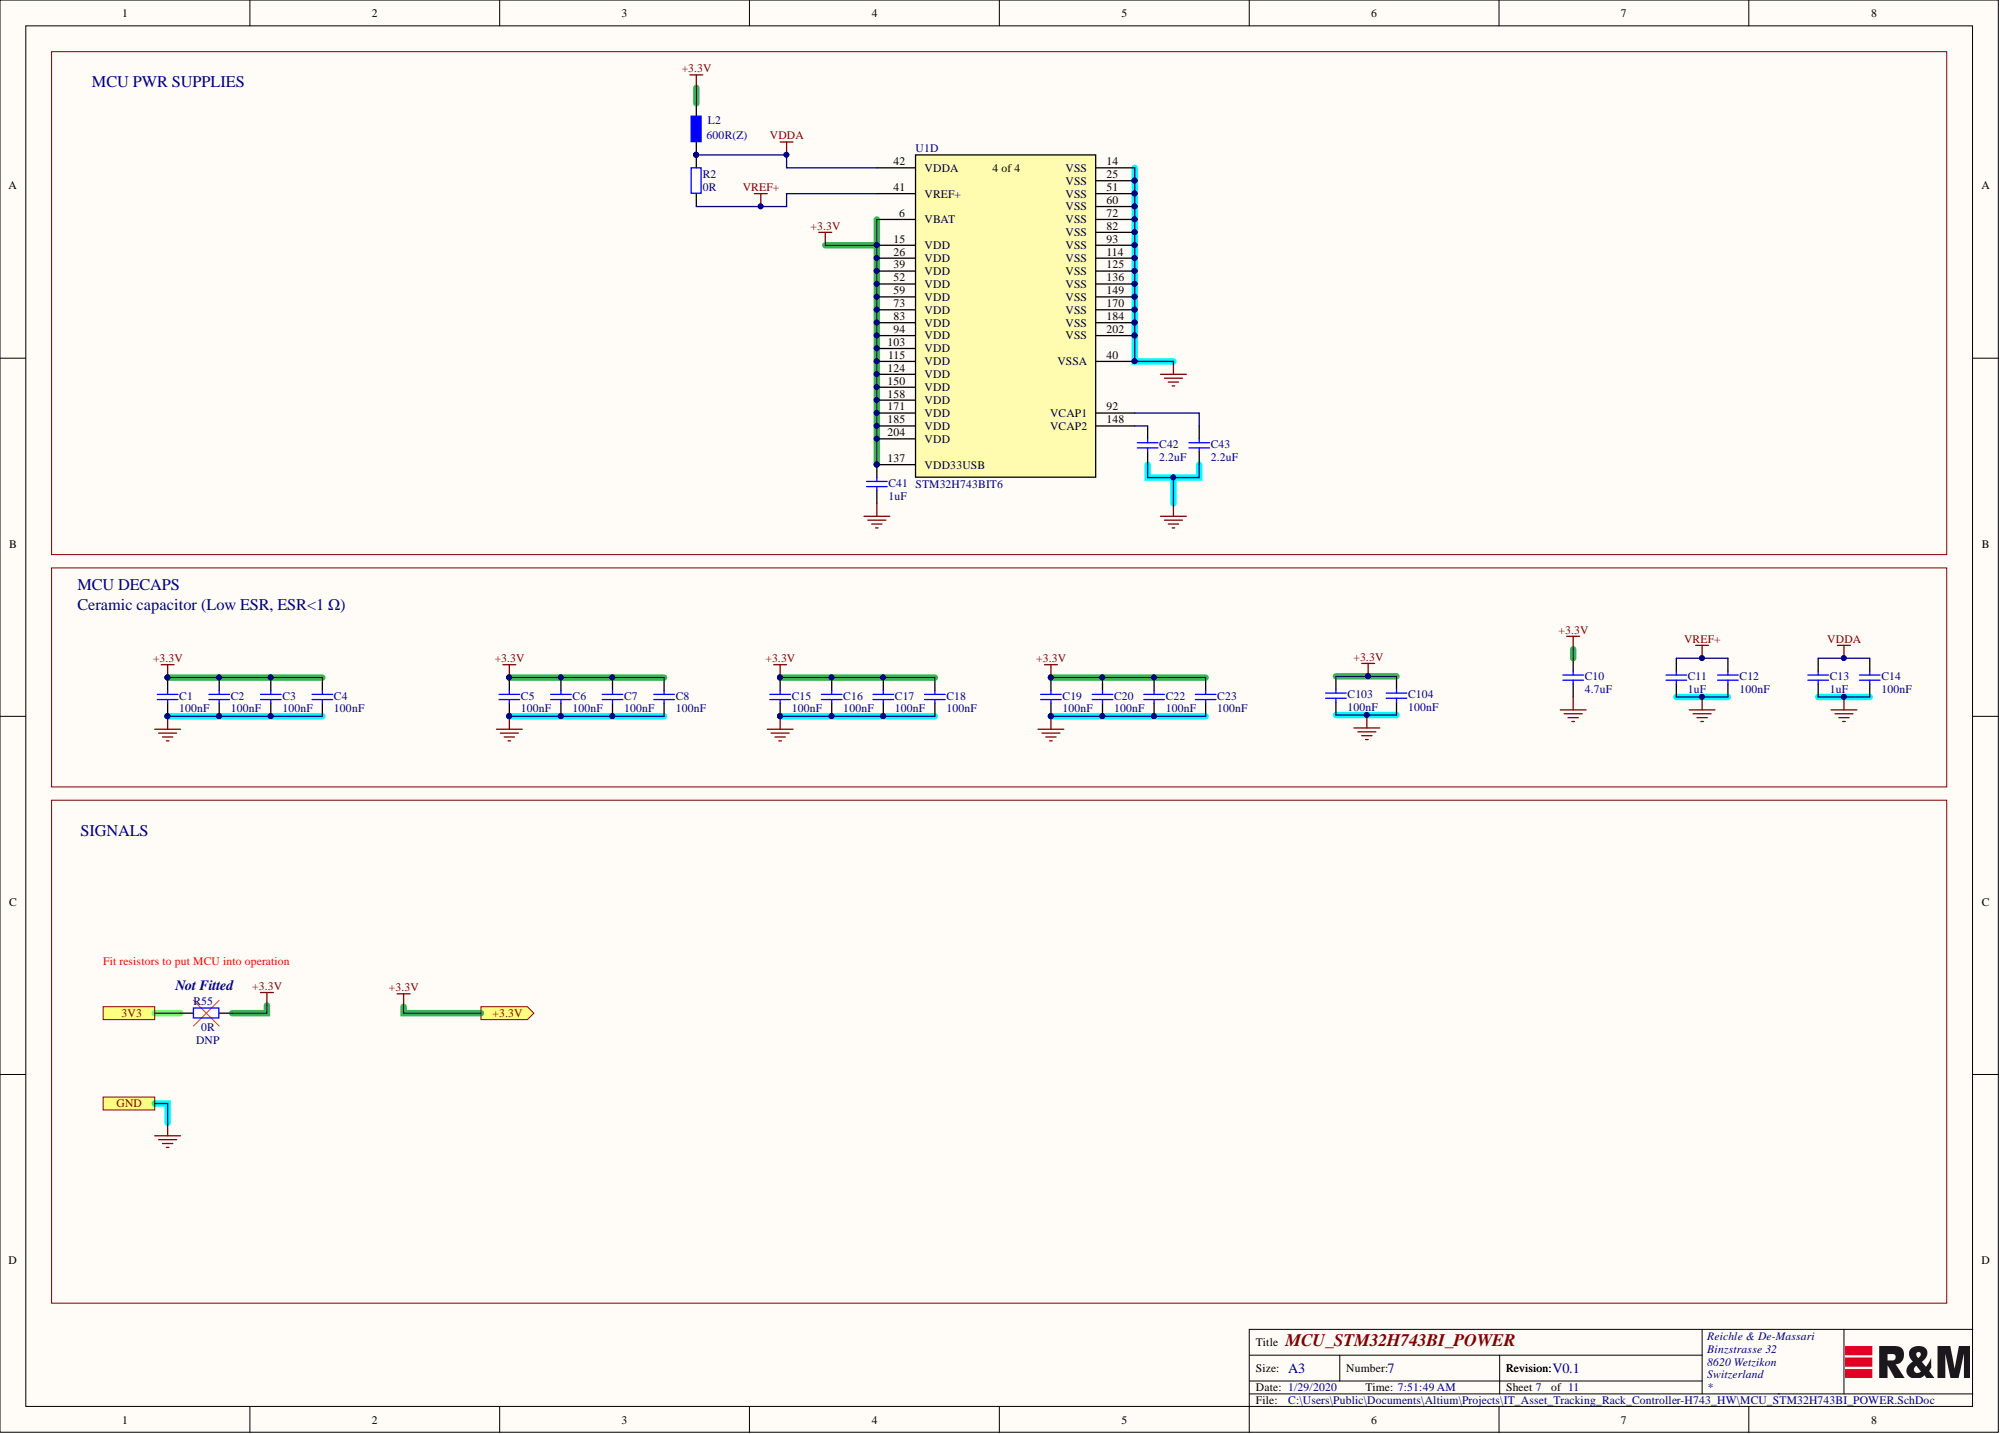
[picture p7: page 7]

MCU DECAPS
Ceramic capacitor (Low ESR, ESR<1 Ω)

Fit resistors to put MCU into operation

C:\Users\Public\Documents\Altium\Projects\IT_Asset_Tracking_Rack_Controller-H743_HW\MCU_STM32H743BI_POWER.SchDoc

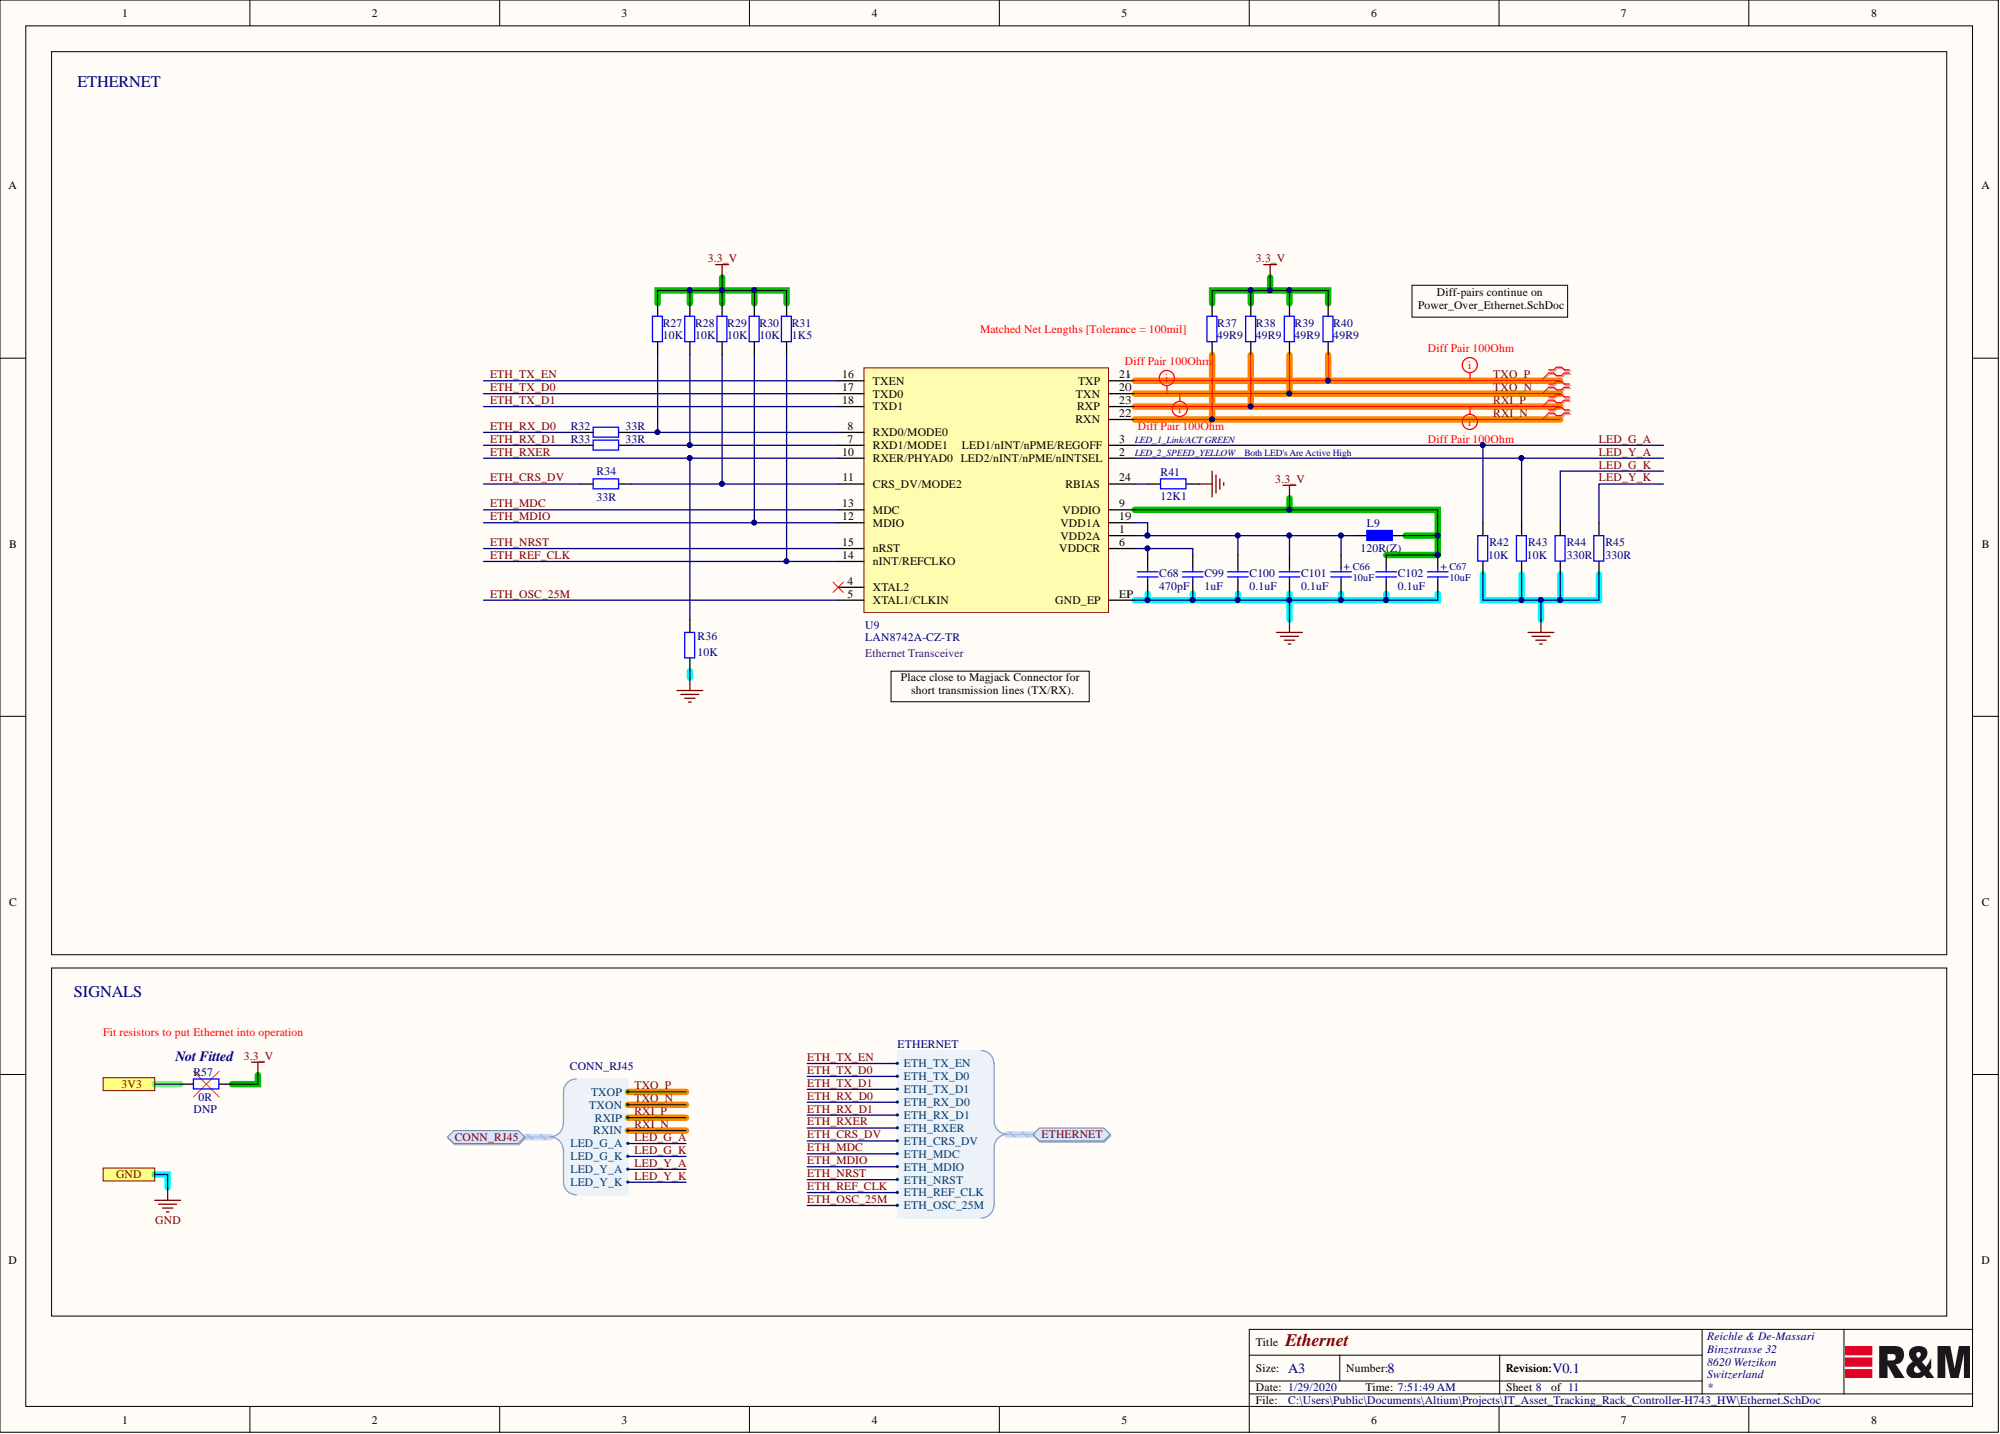
[picture p8: page 8]

Diff-pairs continue on
Power_Over_Ethernet.SchDoc

49R9 Matched Net Lengths [Tolerance = 100mil]

RXER/PHYAD0 10 CRS_DV/MODE2 11 | LED_2_SPEED_YELLOW Both LED's Are Active High | LED_Y_A

LED_G_K

Place close to Magjack Connector for
short transmission lines (TX/RX).

Fit resistors to put Ethernet into operation

C:\Users\Public\Documents\Altium\Projects\IT_Asset_Tracking_Rack_Controller-H743_HW\Ethernet.SchDoc

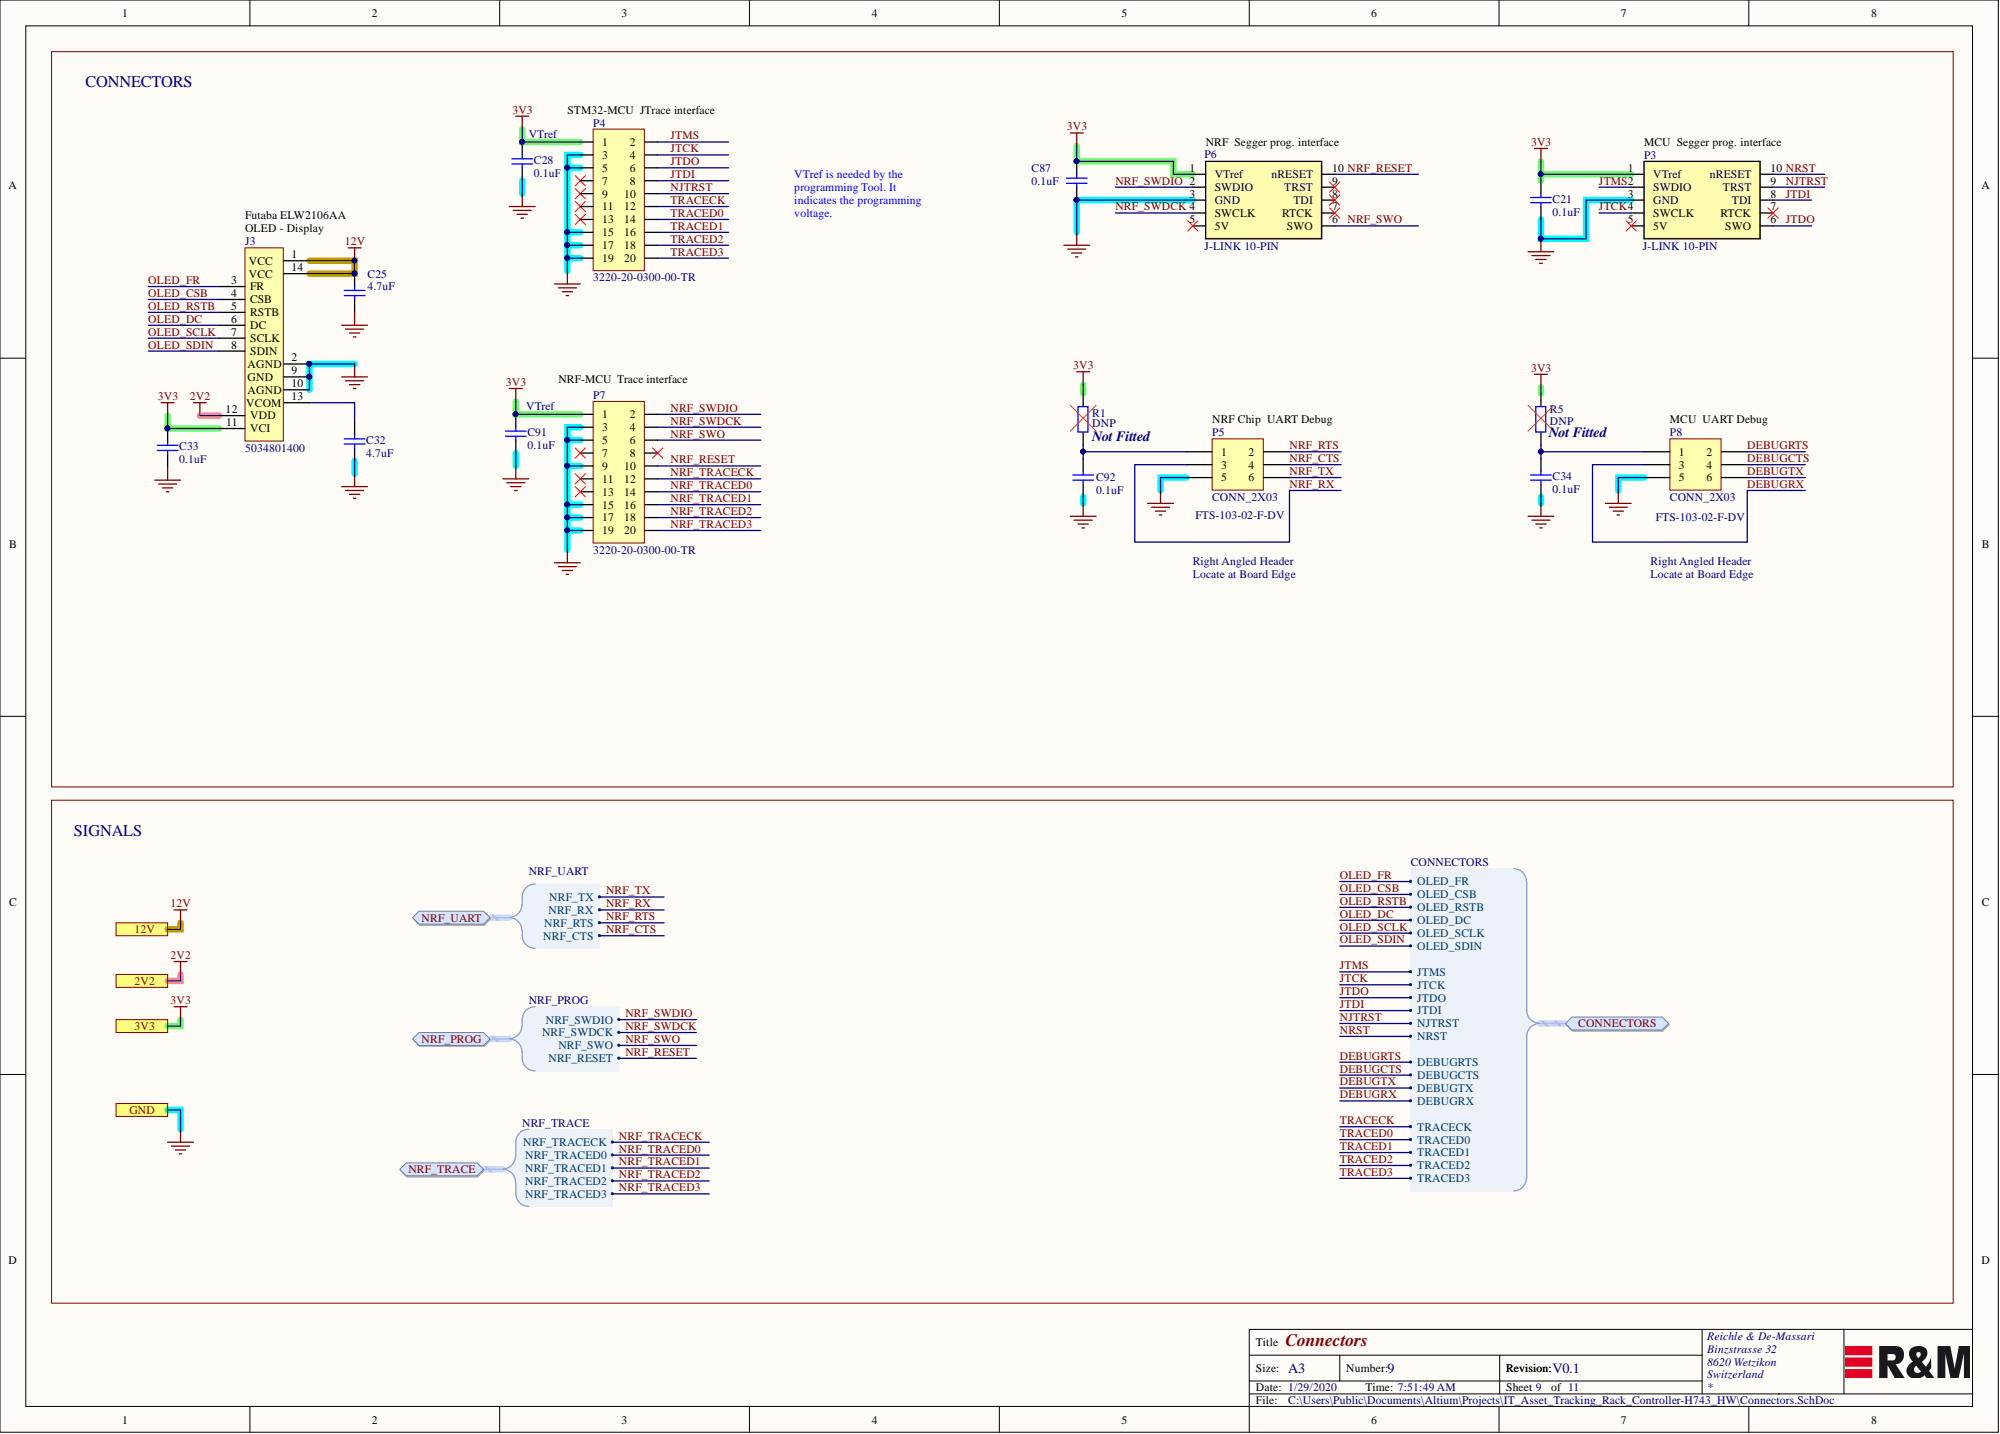
[picture p9: page 9]

VTref is needed by the
programming Tool. It
indicates the programming
voltage.

NRF-MCU Trace interface

Right Angled Header
Locate at Board Edge

C:\Users\Public\Documents\Altium\Projects\IT_Asset_Tracking_Rack_Controller-H743_HW\Connectors.SchDoc

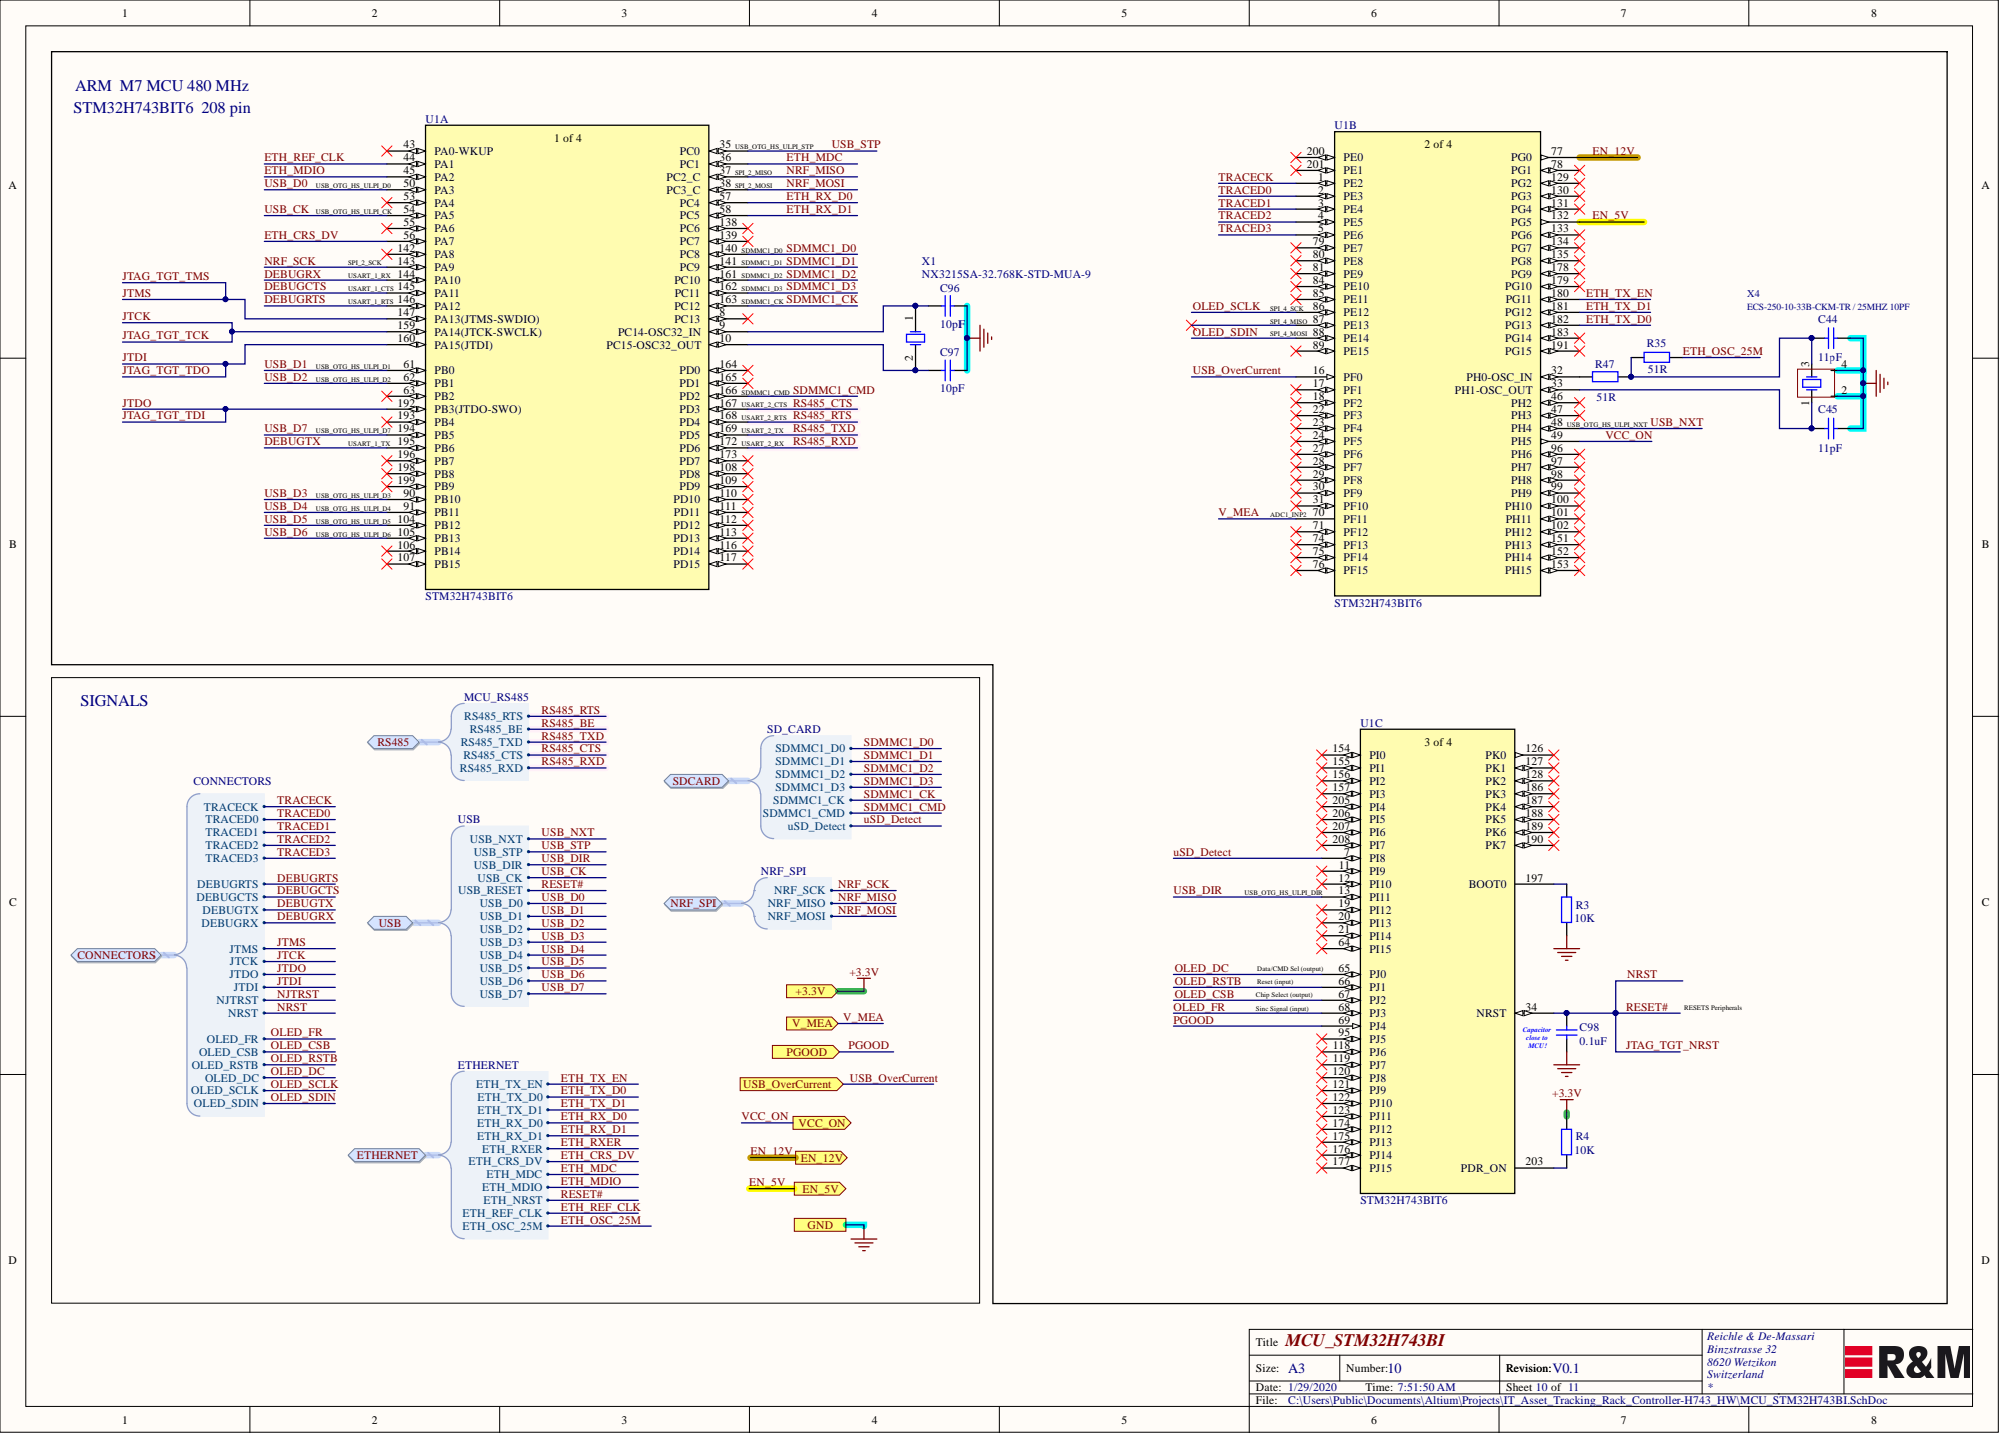
[picture p10: page 10]

Data/CMD Sel (output)

C:\Users\Public\Documents\Altium\Projects\IT_Asset_Tracking_Rack_Controller-H743_HW\MCU_STM32H743BI.SchDoc

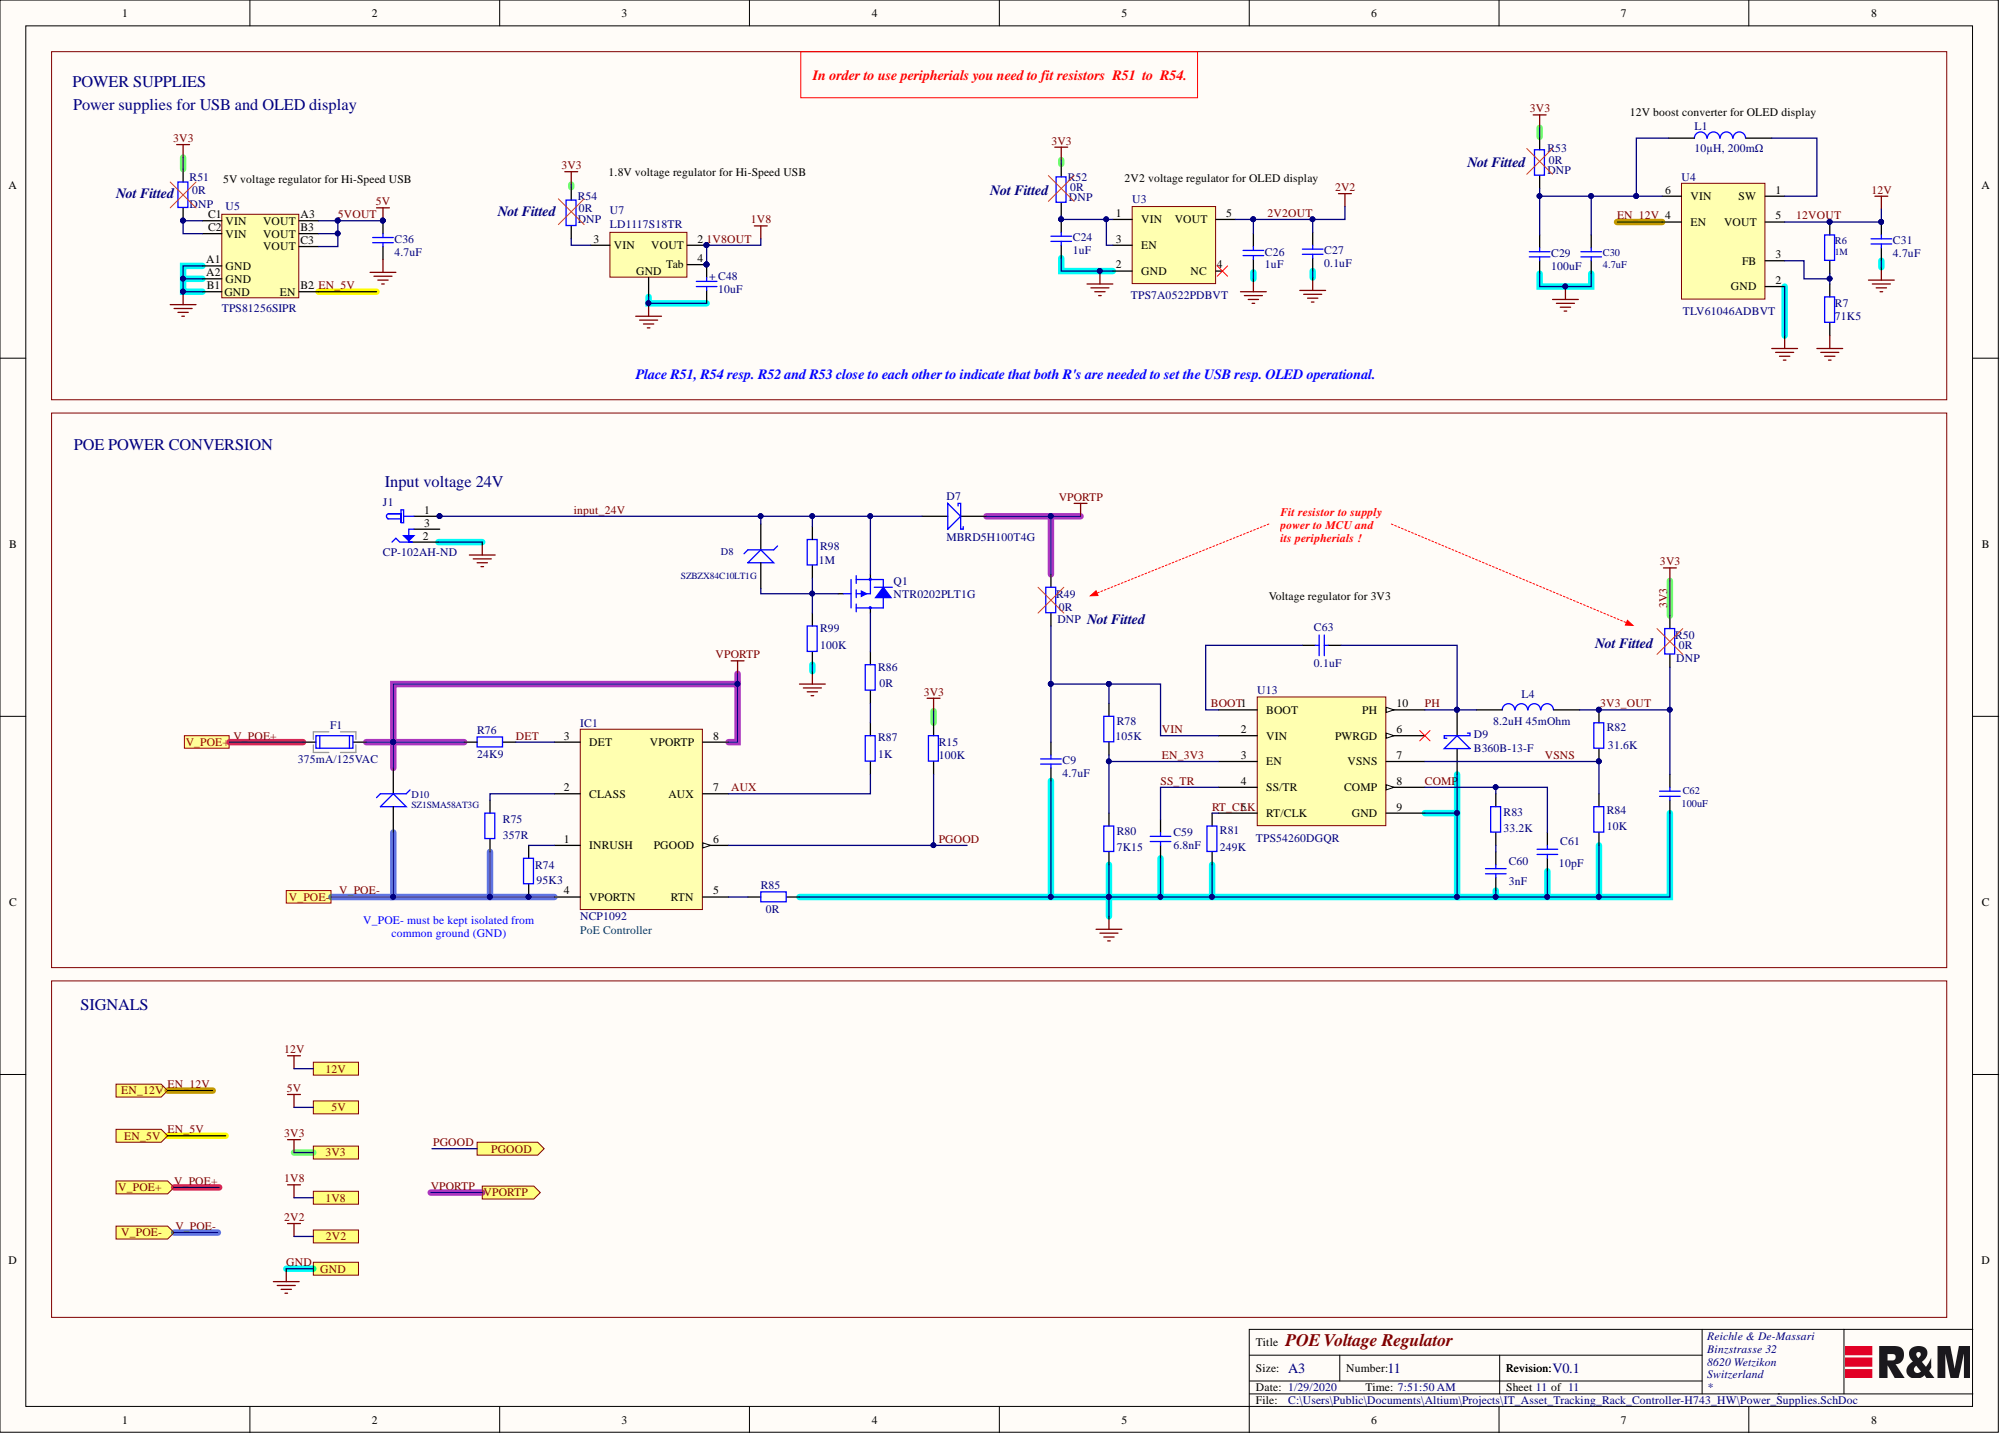
[picture p11: page 11]

In order to use peripherials you need to fit resistors R51 to R54.

5V voltage regulator for Hi-Speed USB

1.8V voltage regulator for Hi-Speed USB

2V2 voltage regulator for OLED display

Place R51, R54 resp. R52 and R53 close to each other to indicate that both R's are needed to set the USB resp. OLED operational.

Fit resistor to supply
power to MCU and
its peripherials !

24K9 D10 | CLASS 2

RT_CLK | RT/CLK 5

INRUSH 1 | R85

V_POE- must be kept isolated from
common ground (GND)

C:\Users\Public\Documents\Altium\Projects\IT_Asset_Tracking_Rack_Controller-H743_HW\Power_Supplies.SchDoc
