mfkiwl/STM32H743_HW/Project Outputs for IT_Asset_Tracking_Rack_Controller-H743/IT_Asset_Tracking_Rack_Controller_Assembly.PDF

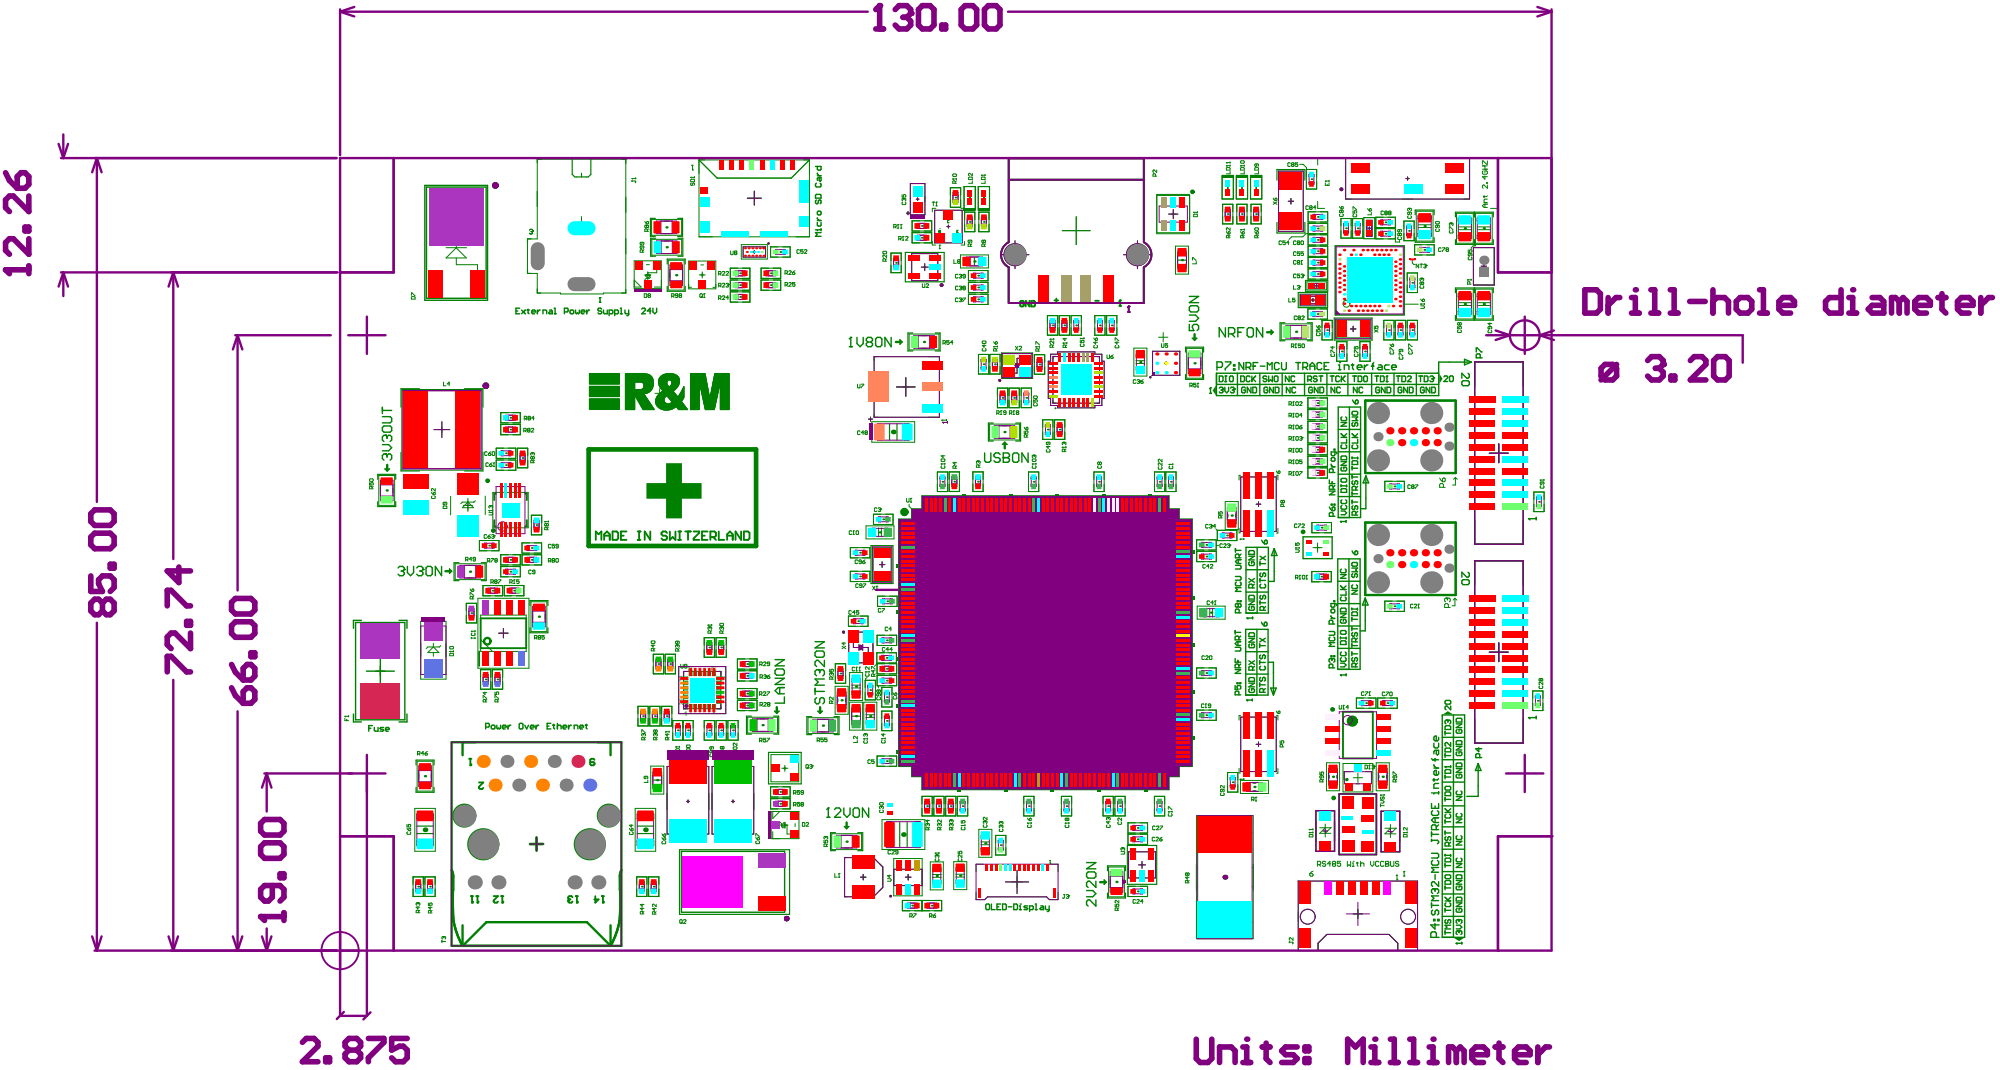
[picture p12: page 1]
