mfkiwl/STM32H743_HW/(list of files, drawings)

Other design files:
Connectors.SchDoc
Ethernet.SchDoc
IT_Asset_Tracking_Rack_Controller-H743.PcbDoc
IT_Asset_Tracking_Rack_Controller-H743.PrjPcb
IT_Asset_Tracking_Rack_Controller-H743.SchDoc
MCU_STM32H743BI.SchDoc
MCU_STM32H743BI_POWER.SchDoc
Micro_SD_Card.SchDoc
NRF52840.SchDoc
Power_Over_Ethernet.SchDoc
Power_Supplies.SchDoc
RDM_ALT_SCH.SchLib
RS-485.SchDoc
USB.SchDoc
