mfkiwl/STM32H743_HW/(commit log)

2020-01-07 first commit, schematics done no pcb layout
    [Connectors.SchDoc, Ethernet.SchDoc, IT_Asset_Tracking_Rack_Controller-H743.PrjPcb, IT_Asset_Tracking_Rack_Controller-H743.SchDoc, MCU_STM32H743BI.SchDoc, MCU_STM32H743BI_POWER.SchDoc, Micro_SD_Card.SchDoc, NRF5284.SchDoc]
2020-01-07 update no pcb layout
    [Connectors.SchDoc, Ethernet.SchDoc, IT_Asset_Tracking_Rack_Controller-H743.SchDoc, MCU_STM32H743BI.SchDoc, MCU_STM32H743BI_POWER.SchDoc, Micro_SD_Card.SchDoc, NRF5284.SchDoc, Power_Over_Ethernet.SchDoc]
2020-01-07 update, no pcb layout
    [IT_Asset_Tracking_Rack_Controller-H743.SchDoc, MCU_STM32H743BI.SchDoc, Micro_SD_Card.SchDoc, Power_Supplies.SchDoc]
2020-01-07 added PCB with Layer Stack
    [IT_Asset_Tracking_Rack_Controller-H743.PcbDoc, IT_Asset_Tracking_Rack_Controller-H743.PrjPcb, IT_Asset_Tracking_Rack_Controller-H743.SchDoc, NRF5284.SchDoc]
2020-01-07 imported components from schematics to pcb
    [Ethernet.SchDoc, Power_Over_Ethernet.SchDoc, Power_Supplies.SchDoc, RDM_ALT_SCH.SchLib, RS-485.SchDoc, USB.SchDoc]
2020-01-08 added some comments to the schematics
    [Connectors.SchDoc, Ethernet.SchDoc, IT_Asset_Tracking_Rack_Controller-H743.SchDoc, MCU_STM32H743BI.SchDoc, Power_Over_Ethernet.SchDoc, Power_Supplies.SchDoc, RDM_ALT_SCH.SchLib, USB.SchDoc]
2020-01-08 Added Fuse with holder
    [Connectors.SchDoc, IT_Asset_Tracking_Rack_Controller-H743.PrjPcb, IT_Asset_Tracking_Rack_Controller-H743.SchDoc, NRF5284.SchDoc, NRF52840.SchDoc, Power_Over_Ethernet.SchDoc, Power_Supplies.SchDoc, RDM_ALT_SCH.SchLib]
2020-01-09 All components aside pcb and ready to layout.
    [Connectors.SchDoc, Ethernet.SchDoc, IT_Asset_Tracking_Rack_Controller-H743.PrjPcb, IT_Asset_Tracking_Rack_Controller-H743.SchDoc, MCU_STM32H743BI.SchDoc, MCU_STM32H743BI_POWER.SchDoc, Micro_SD_Card.SchDoc, NRF52840.SchDoc]
2020-01-10 Board with cutouts, dimensions ant Net-colours
    [Ethernet.SchDoc, IT_Asset_Tracking_Rack_Controller-H743.PrjPcb, IT_Asset_Tracking_Rack_Controller-H743.SchDoc, MCU_STM32H743BI_POWER.SchDoc, Power_Over_Ethernet.SchDoc, Power_Supplies.SchDoc, RS-485.SchDoc, USB.SchDoc]
2020-01-10 Added couplling Caps for ST-MCU
    [Connectors.SchDoc, Ethernet.SchDoc, IT_Asset_Tracking_Rack_Controller-H743.PrjPcb, MCU_STM32H743BI_POWER.SchDoc, NRF52840.SchDoc, Power_Supplies.SchDoc, RDM_ALT_SCH.SchLib, RS-485.SchDoc]
2020-01-13 NCP1091: separated GND from V_POE-
    [Connectors.SchDoc, IT_Asset_Tracking_Rack_Controller-H743.PrjPcb, IT_Asset_Tracking_Rack_Controller-H743.SchDoc, MCU_STM32H743BI.SchDoc, MCU_STM32H743BI_POWER.SchDoc, Power_Over_Ethernet.SchDoc, Power_Supplies.SchDoc, RDM_ALT_SCH.SchLib]
2020-01-14 Added P-MOS-FET to switch VCCBUS ON or OFF
    [Ethernet.SchDoc, IT_Asset_Tracking_Rack_Controller-H743.PrjPcb, IT_Asset_Tracking_Rack_Controller-H743.SchDoc, MCU_STM32H743BI.SchDoc, NRF52840.SchDoc, Power_Over_Ethernet.SchDoc, Power_Supplies.SchDoc, RDM_ALT_SCH.SchLib]
2020-01-15 All components arranged on PCB, nothing routed
    [IT_Asset_Tracking_Rack_Controller-H743.PrjPcb, IT_Asset_Tracking_Rack_Controller-H743.SchDoc, MCU_STM32H743BI.SchDoc, NRF52840.SchDoc, Power_Supplies.SchDoc, RDM_ALT_SCH.SchLib, RS-485.SchDoc, USB.SchDoc]
2020-01-16 Alligned all components to 10 mil grid, nothing routed
    [IT_Asset_Tracking_Rack_Controller-H743.PrjPcb]
2020-01-16 Adjusted total PCB thikness to 1.6 mm in the layerstack manager
    [Power_Supplies.SchDoc]
2020-01-17 Updated Layerstack
    [IT_Asset_Tracking_Rack_Controller-H743.PrjPcb, Power_Supplies.SchDoc]
2020-01-20 Routed VPORTP an Diff. Pairs
    [Ethernet.SchDoc, IT_Asset_Tracking_Rack_Controller-H743.PrjPcb, IT_Asset_Tracking_Rack_Controller-H743.SchDoc, MCU_STM32H743BI.SchDoc, MCU_STM32H743BI_POWER.SchDoc, Micro_SD_Card.SchDoc, NRF52840.SchDoc, Power_Over_Ethernet.SchDoc]
2020-01-20 Added +3.3V Region for Ethernet
    [MCU_STM32H743BI_POWER.SchDoc]
2020-01-21 Added separate 3.3V plane for ST-MCU
    [IT_Asset_Tracking_Rack_Controller-H743.SchDoc, MCU_STM32H743BI.SchDoc, MCU_STM32H743BI_POWER.SchDoc, Power_Supplies.SchDoc]
2020-01-21 Routed USB
    [Power_Supplies.SchDoc]
2020-01-22 Added new room with rule for routing under the NRF chip
    [IT_Asset_Tracking_Rack_Controller-H743.PrjPcb]
2020-01-22 NRF Chip left to route
    [MCU_STM32H743BI.SchDoc, Power_Supplies.SchDoc]
2020-01-23 Routed NRF52840 chip
    [NRF52840.SchDoc]
2020-01-23 Removed R96 in Schema RS-485
    [RS-485.SchDoc]
2020-01-24 Added pin description for the JTAG connectors
    [Connectors.SchDoc, IT_Asset_Tracking_Rack_Controller-H743.PrjPcb, IT_Asset_Tracking_Rack_Controller-H743.SchDoc, RS-485.SchDoc]
2020-01-27 Added labels for the connectors
    [Connectors.SchDoc, IT_Asset_Tracking_Rack_Controller-H743.PrjPcb]
2020-01-27 Added further labels
    [Power_Supplies.SchDoc, RS-485.SchDoc]
2020-01-27 Added additional descriptions to schematic
    [Connectors.SchDoc, IT_Asset_Tracking_Rack_Controller-H743.PrjPcb]
2020-01-27 Added project output files
    [Bill of Materials-IT_Asset_Tracking_Rack_Controller-H743.xls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]
2020-01-29 Added plated drill-holes and recreated all outputfiles
    [IT_Asset_Tracking_Rack_Controller-H743.GBL, IT_Asset_Tracking_Rack_Controller-H743.GBO, IT_Asset_Tracking_Rack_Controller-H743.GBS, IT_Asset_Tracking_Rack_Controller-H743.GKO, IT_Asset_Tracking_Rack_Controller-H743.GTL, IT_Asset_Tracking_Rack_Controller-H743.GTO, IT_Asset_Tracking_Rack_Controller-H743.GTP, IT_Asset_Tracking_Rack_Controller-H743.GTS]
